alcor6502/SuperCap-UPS-RasPi-Altium/README.md

# Altium Project for RasPi SuperCap UPS & Power Supply

## Follow the project on [Hackaday](https://hackaday.io/project/168748-raspberry-supercapacitor-ups-power-supply)

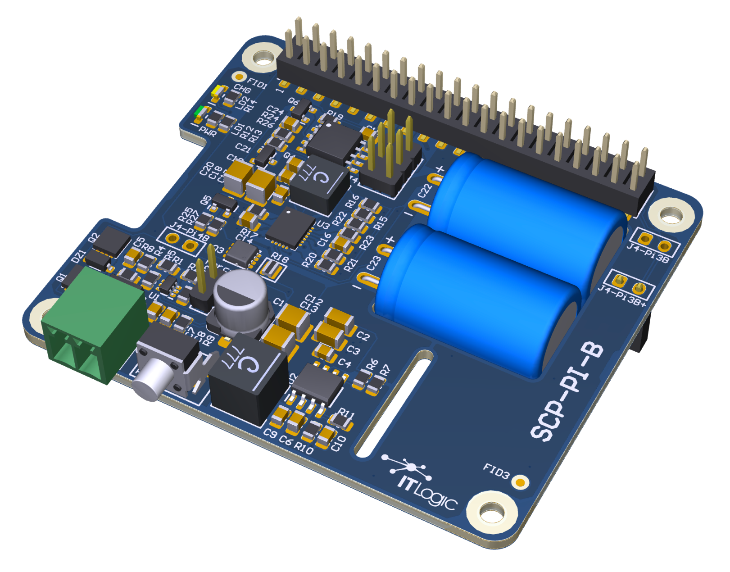
[picture p1: Documentation/Pictures/SCP-PI-B.png]
image info
