alcor6502/SuperCap-UPS-RasPi-Altium/Documentation/Design Rules Check/Design Rules Check.html

Altium

# Design Rule Verification Report

Date: | | 11/17/2019
Time: | | 7:34:54 PM
Elapsed Time: | | 00:00:02
Filename: | | C:\Users\alfredo\AppData\Local\TempReleases\Snapshot\1\SCAP-PI.PcbDoc

Warnings: | | 0
Rule Violations: | | 0

## Summary

Warnings | Count
Total | 0

Rule Violations | Count
Clearance Constraint (Gap=0.2mm) (All),(All) | 0
Clearance Constraint (Gap=0.2mm) (HasFootprint('HLE-120-02-F-DV-BE')),(All) | 0
Short-Circuit Constraint (Allowed=No) (All),(All) | 0
Un-Routed Net Constraint ( (All) ) | 0
Modified Polygon (Allow modified: No), (Allow shelved: No) | 0
Width Constraint (Min=0.2mm) (Max=5mm) (Preferred=0.2mm) (All) | 0
Routing Layers(All) | 0
Routing Via (MinHoleWidth=0.3mm) (MaxHoleWidth=0.6mm) (PreferredHoleWidth=0.3mm) (MinWidth=0.6mm) (MaxWidth=1mm) (PreferedWidth=0.6mm) (All) | 0
Differential Pairs Uncoupled Length using the Gap Constraints (Min=0.2mm) (Max=0.4mm) (Prefered=0.2mm) and Width Constraints (Min=0.3mm) (Max=0.4mm) (Prefered=0.3mm) (All) | 0
SMD To Corner (Distance=0mm) (All) | 0
SMD Entry (Side = Allowed) (Corner = Not Allowed) (Any Angle = Allowed) (Ignore First Corner = Allowed) | 0
Power Plane Connect Rule(Direct Connect )(Expansion=0.5mm) (Conductor Width=0.2mm) (Air Gap=0.2mm) (Entries=4) (All) | 0
Power Plane Connect Rule(Relief Connect )(Expansion=0.3mm) (Conductor Width=0.5mm) (Air Gap=0.2mm) (Entries=4) ((InNet('GND') and IsPad)) | 0
Minimum Annular Ring (Minimum=0.15mm) (All) | 0
Acute Angle Constraint [Tracks Only] (Minimum=0.000) (All) | 0
Hole Size Constraint (Min=0.3mm) (Max=6mm) (All) | 0
Pads and Vias to follow the Drill pairs settings | 0
Hole To Hole Clearance (Gap=0.3mm) (All),(All) | 0
Minimum Solder Mask Sliver (Gap=0.15mm) (All),(All) | 0
Silk To Solder Mask (Clearance=0.1mm) (IsPad),(All) | 0
Silk to Silk (Clearance=0.1mm) (All),(All) | 0
Net Antennae (Tolerance=0mm) (All) | 0
Board Clearance Constraint (Gap=0mm) ((OnLayer('Top Layer') OR OnLayer('Bottom Layer'))) | 0
Component Clearance Constraint ( Horizontal Gap = 0mm, Vertical Gap = 0mm ) (HasFootprint('C-SCCT20B106PRB-ORIZ')),(All) | 0
Component Clearance Constraint ( Horizontal Gap = 0mm, Vertical Gap = 0mm ) (HasFootprint('SSQ-120-03-D-BOTTOM')),(All) | 0
Component Clearance Constraint ( Horizontal Gap = 0mm, Vertical Gap = 0mm ) (Footprint Like('FID-1*')),(All) | 0
Component Clearance Constraint ( Horizontal Gap = 0.2mm, Vertical Gap = 0.2mm ) (All),(All) | 0
Height Constraint (Min=0mm) (Max=50mm) (Prefered=12mm) (All) | 0
Total | 0
