alcor6502/SuperCap-UPS-RasPi-Altium/Documentation/Project Specs/DAC Linerization AVR.xlsx

Ratio Vin/Vout | 3
DAC Resolution | 256
VREF | 2.56
Input Voltage | 3.2
Resistor Divider Voltage | 1.07
Digital Value RAW | 106.67
Correction coefficent | 30
Digital Value COND | 3200
