alcor6502/SuperCap-UPS-RasPi-Altium/Documentation/Project Specs/Parameter Calculator.xlsx

SCAP-PI |  | APP NOTE
RFB1 | 1000 | RFB1 | 1500
RFB2 | 200 | RFB2 | 324
VCHG | 4.80 | VCHG | 4.50
SCAP-PI |  | APP NOTE
RFB1 | 120 | RFB1 | 113
RFB2 | 39 | RFB2 | 38.3
VPF | 4.85 | VPF | 4.70
SCAP-PI |  | APP NOTE
RFB1 | 1050 | RFB1 | 1050
RFB2 | 200 | RFB2 | 200
VSYS | 5.00 | VSYS | 5.00
VSYSGD | 4.62 | VSYSGD | 4.62
LAMP
RFB1 | 100
RFB2 | 9.1
VSYS | 7.15
