alcor6502/SuperCap-UPS-RasPi-Altium/Documentation/Foto/SCP-PI-A-01.jpeg

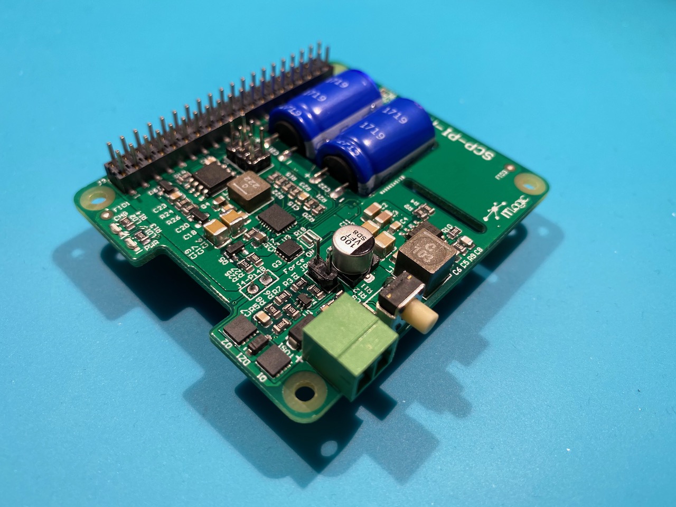
Documentation/Foto/SCP-PI-A-01.jpeg
