alcor6502/SuperCap-UPS-RasPi-Altium/Documentation/Foto/SCP-PI-A-05.jpeg

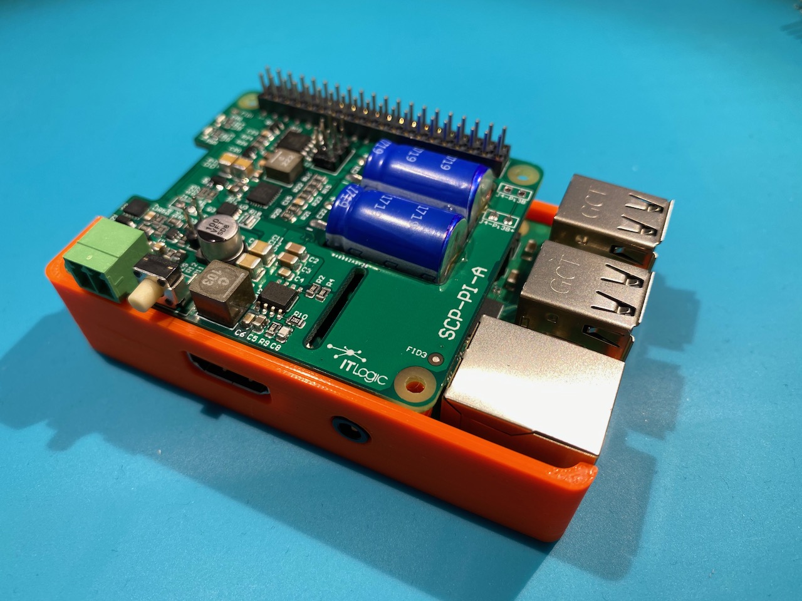
Documentation/Foto/SCP-PI-A-05.jpeg
