alcor6502/SuperCap-UPS-RasPi-Altium/Documentation/Hackday Article/ATTiny25.jpg

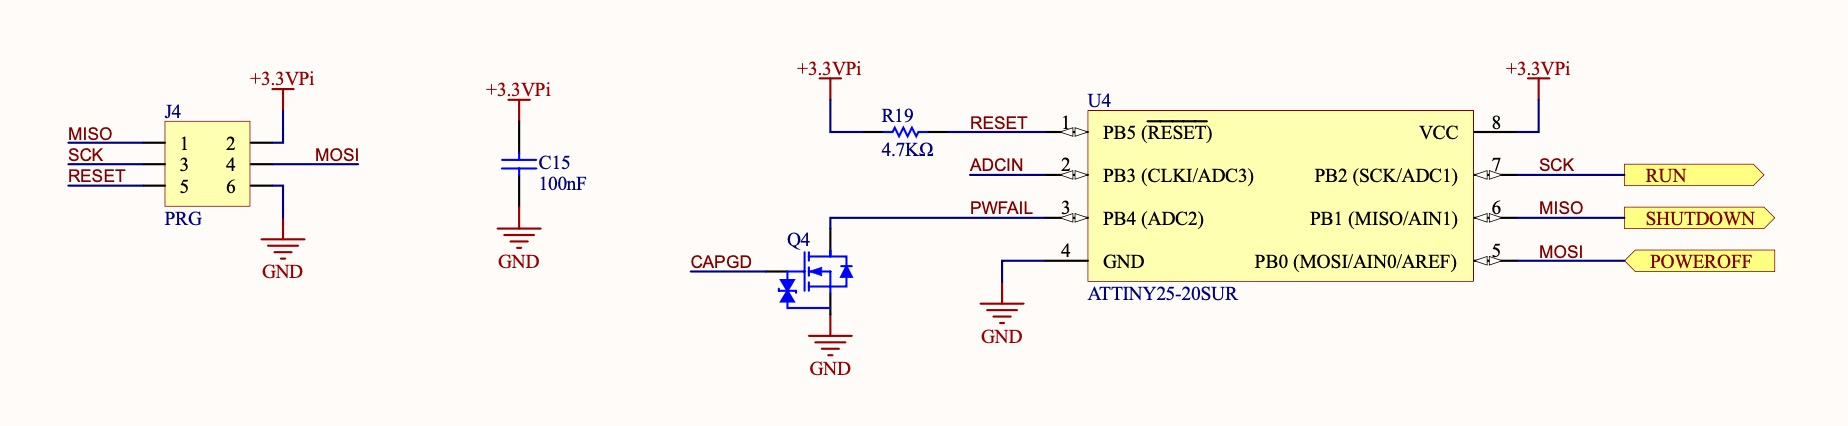
Documentation/Hackday Article/ATTiny25.jpg
