alcor6502/SuperCap-UPS-RasPi-Altium/Documentation/Hackday Article/Lab-Bench.jpeg

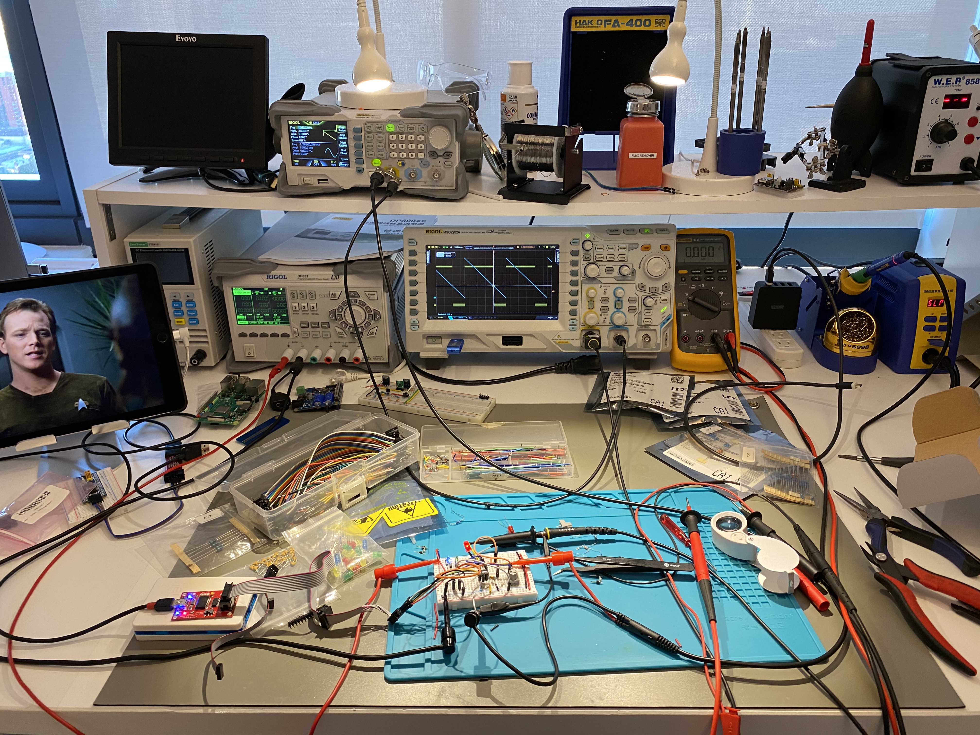
Documentation/Hackday Article/Lab-Bench.jpeg
