alcor6502/SuperCap-UPS-RasPi-Altium/Documentation/Hackday Article/MAX16054-Solution.jpg

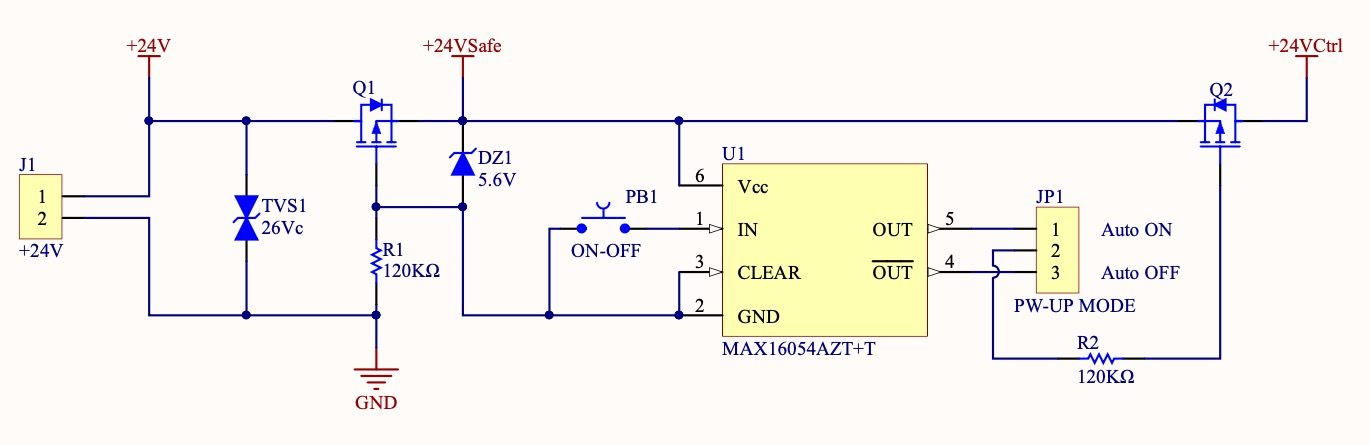
Documentation/Hackday Article/MAX16054-Solution.jpg
