alcor6502/SuperCap-UPS-RasPi-Altium/Documentation/Hackday Article/Original-Circuit.jpg

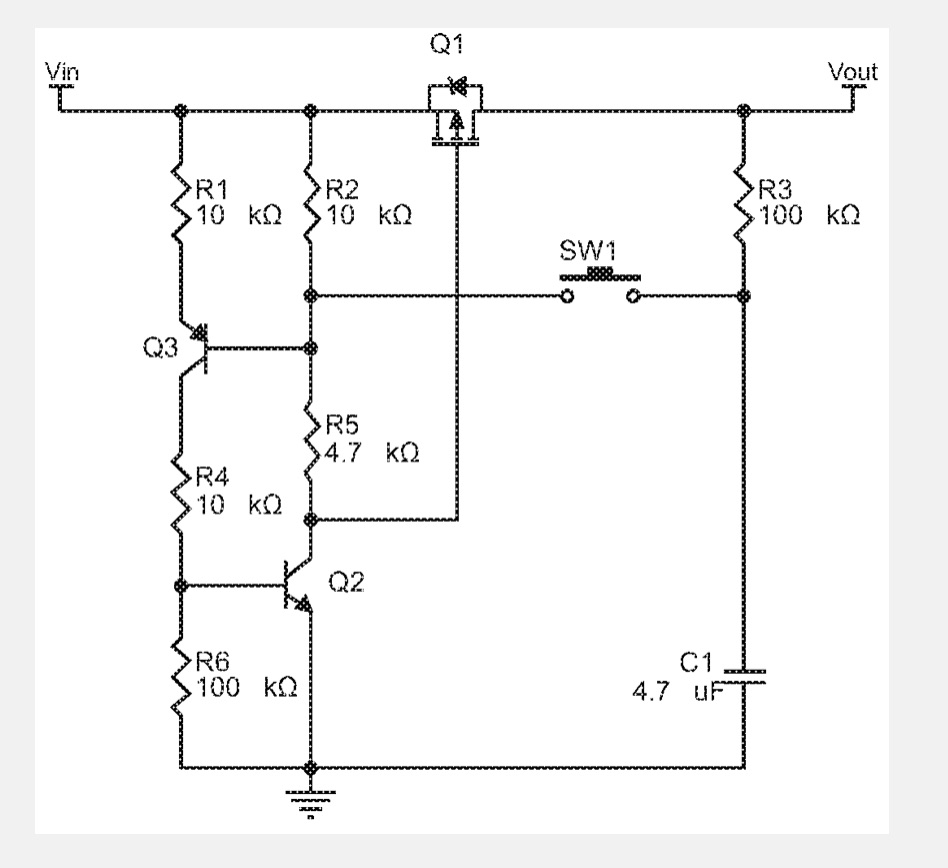
Documentation/Hackday Article/Original-Circuit.jpg
