alcor6502/SuperCap-UPS-RasPi-Altium/Documentation/Hackday Article/Power-Supply.jpg

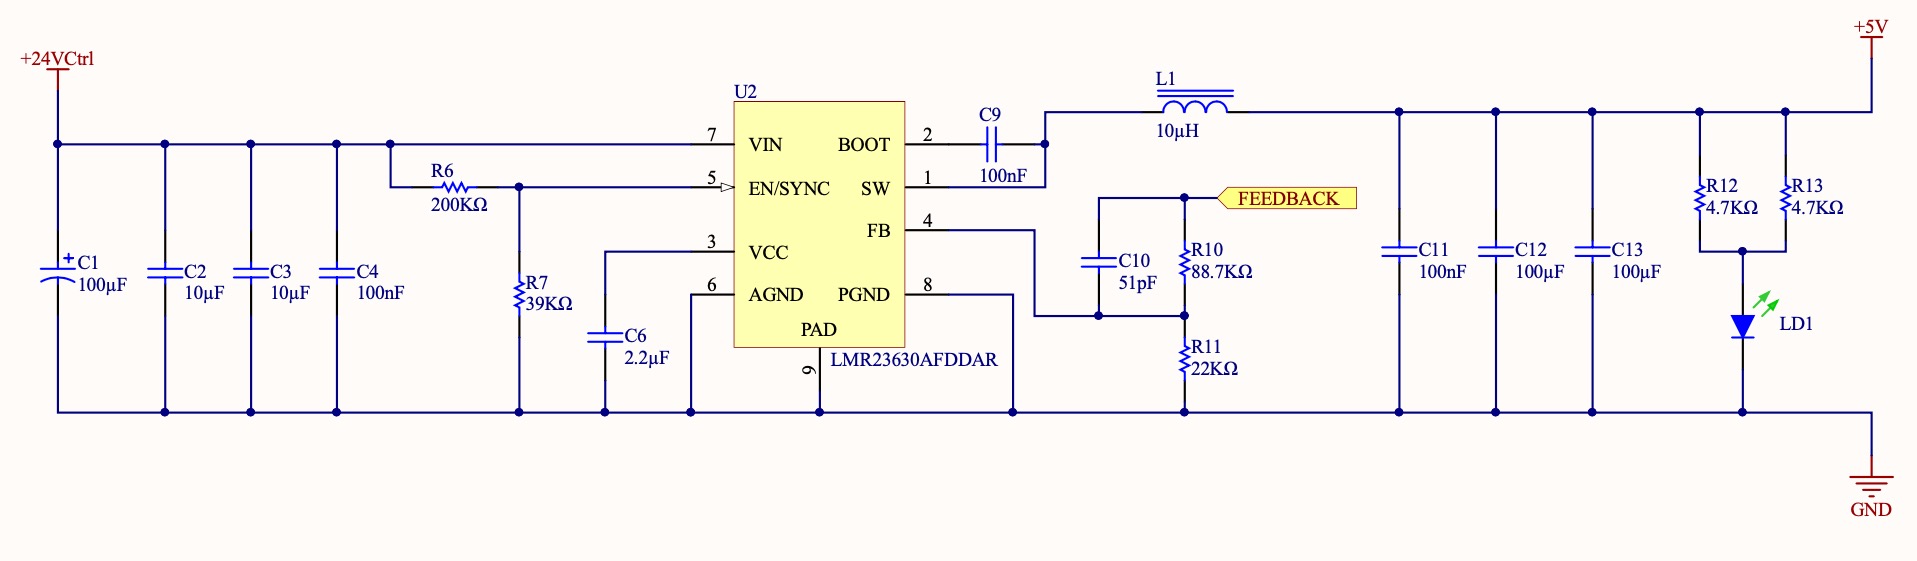
Documentation/Hackday Article/Power-Supply.jpg
