alcor6502/SuperCap-UPS-RasPi-Altium/Documentation/Hackday Article/Soft-Latching-Power-Switch-Circuit.jpg

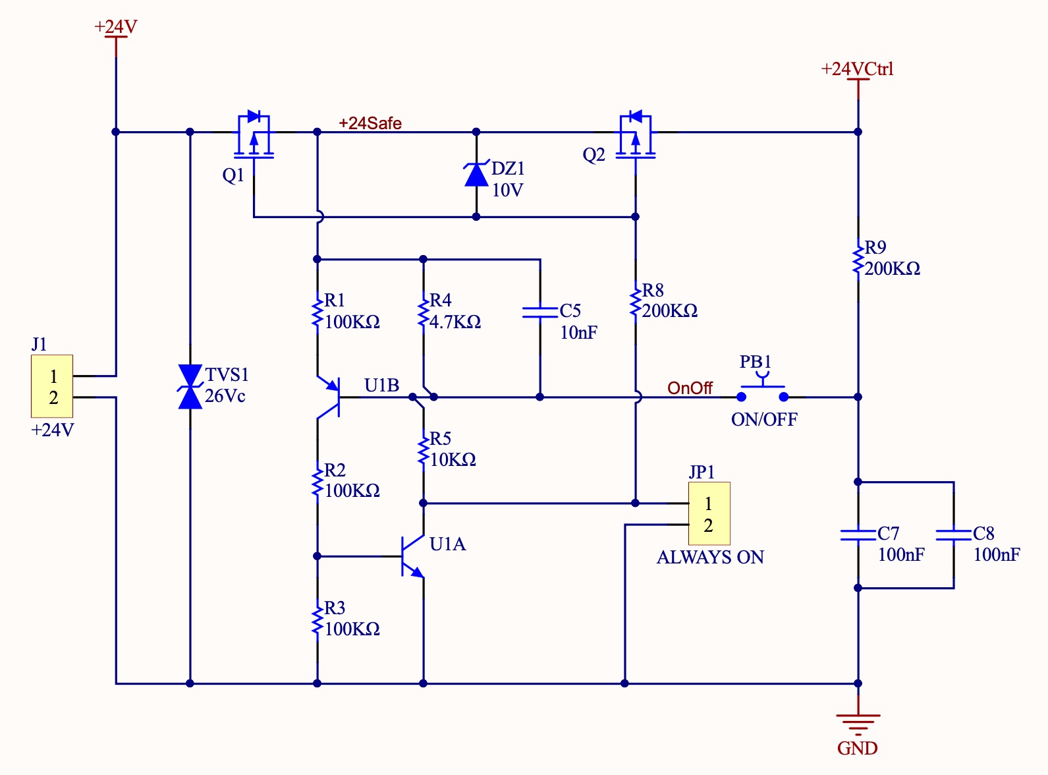
Documentation/Hackday Article/Soft-Latching-Power-Switch-Circuit.jpg
