alcor6502/SuperCap-UPS-RasPi-Altium/Documentation/Hackday Article/SuperCap-UPS.jpg

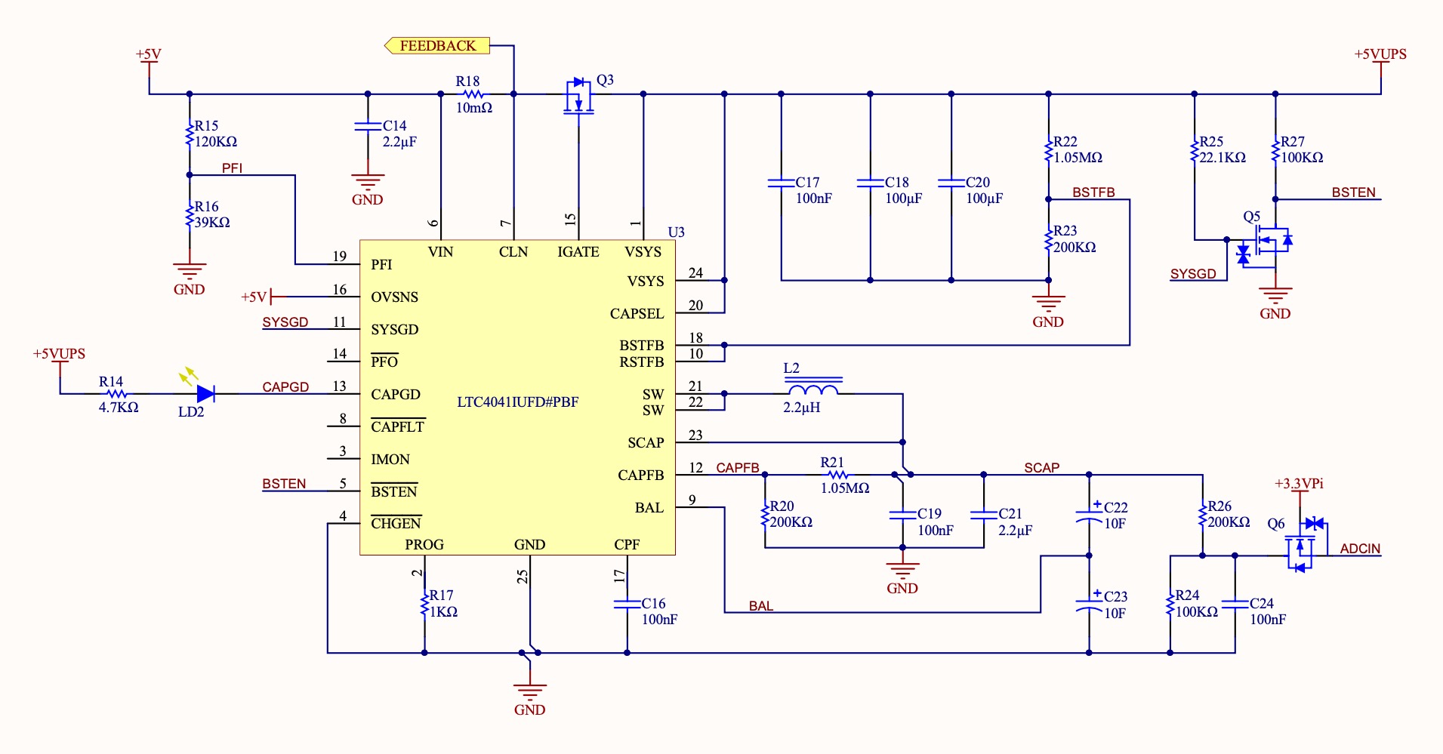
Documentation/Hackday Article/SuperCap-UPS.jpg
