alcor6502/SuperCap-UPS-RasPi-Altium/Documentation/Screen Captures/Power Off with BSTEN Signal - Pulse Load 2A - 20ms Off - 5ms On.png

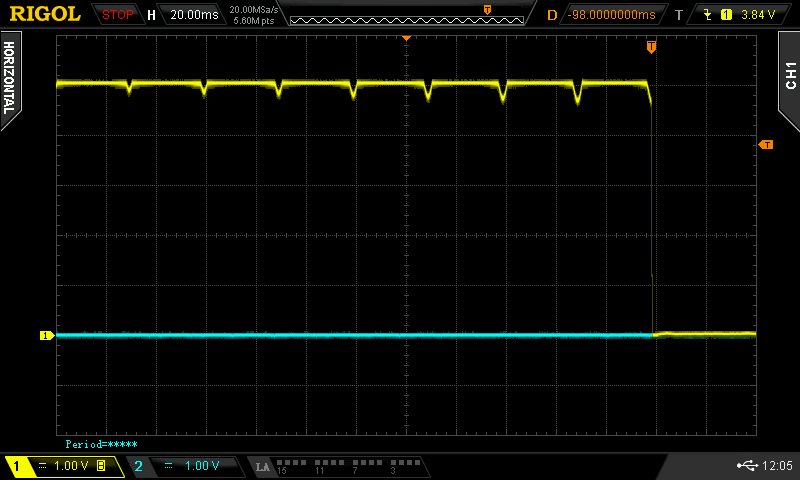
Documentation/Screen Captures/Power Off with BSTEN Signal - Pulse Load 2A - 20ms Off - 5ms On.png
