alcor6502/SuperCap-UPS-RasPi-Altium/Documentation/Screen Captures/Power Off with BSTEN Signal.png

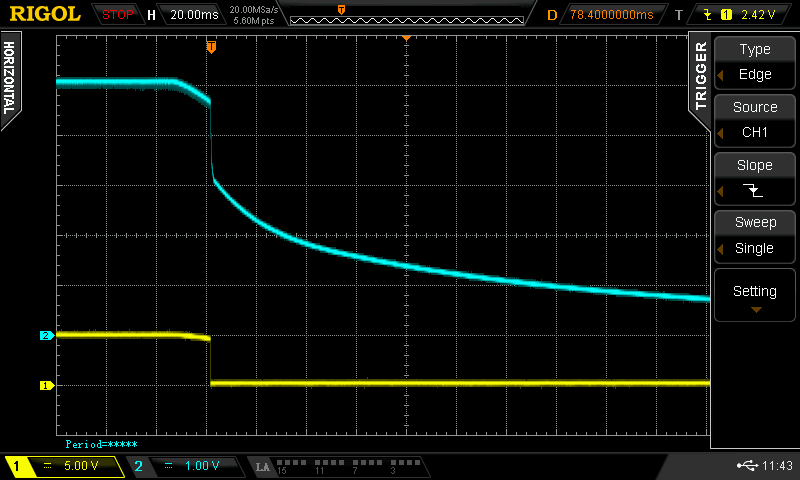
Documentation/Screen Captures/Power Off with BSTEN Signal.png
