alcor6502/SuperCap-UPS-RasPi-Altium/Documentation/Screen Captures/Power Off without BSTEN Signal - Magnified.png

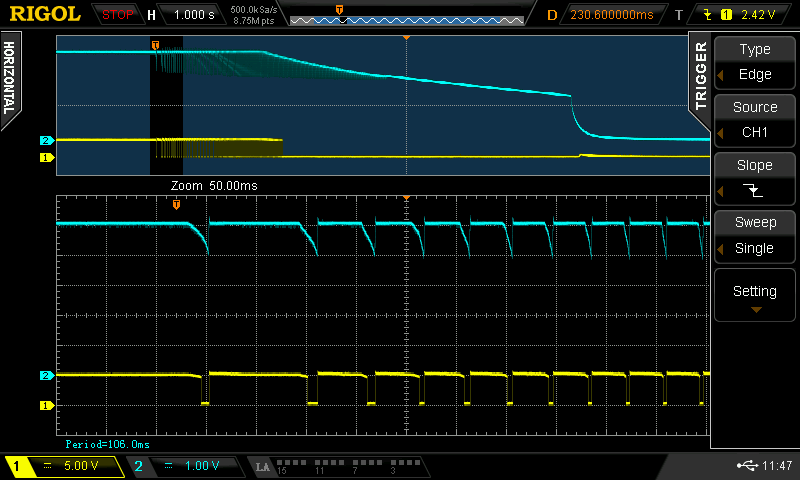
Documentation/Screen Captures/Power Off without BSTEN Signal - Magnified.png
