alcor6502/SuperCap-UPS-RasPi-Altium/Documentation/Screen Captures/Power Off without BSTEN Signal.png

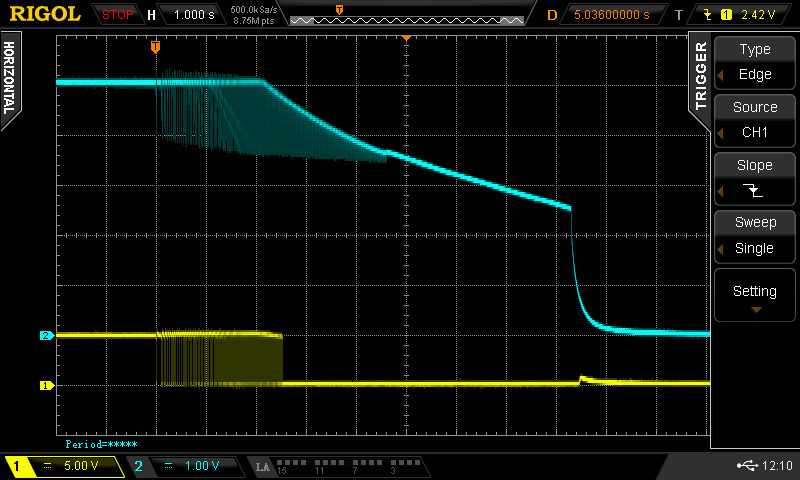
Documentation/Screen Captures/Power Off without BSTEN Signal.png
