alcor6502/SuperCap-UPS-RasPi-Altium/Documentation/Screen Captures/Ripple Boost 0.5A - Polling Shunt and Boost.png

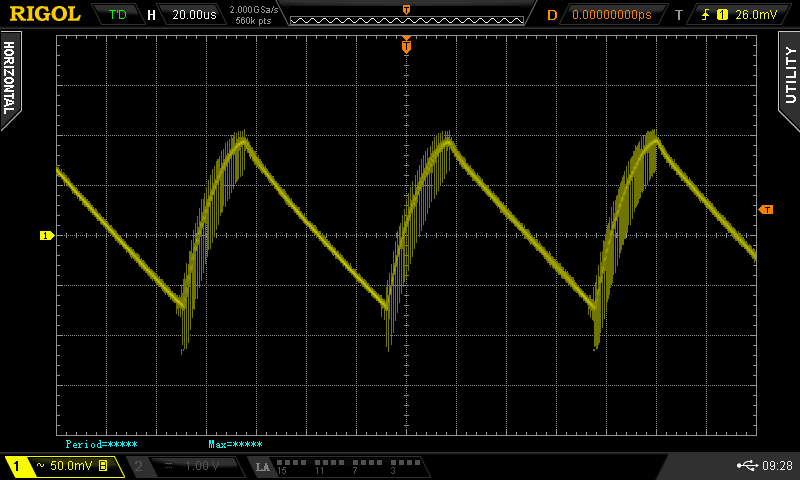
Documentation/Screen Captures/Ripple Boost 0.5A - Polling Shunt and Boost.png
