alcor6502/SuperCap-UPS-RasPi-Altium/Documentation/Screen Captures/Ripple Boost 1A.png

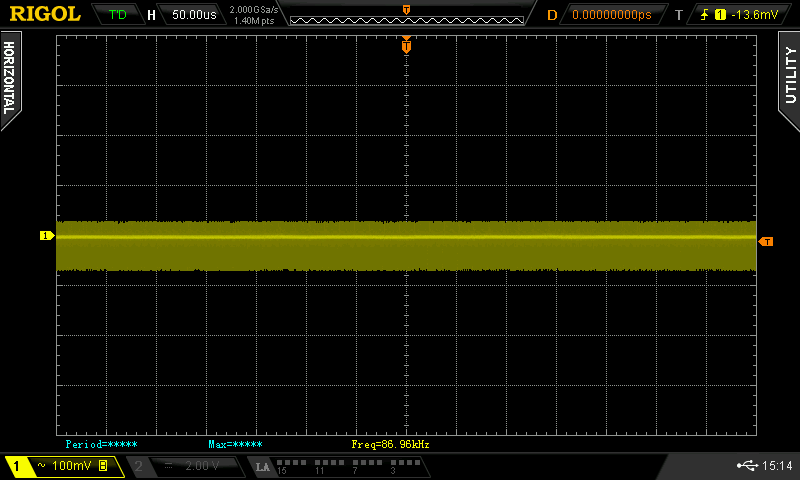
Documentation/Screen Captures/Ripple Boost 1A.png
