alcor6502/SuperCap-UPS-RasPi-Altium/Documentation/Screen Captures/Ripple Boost Transient 2A - 0.1A.png

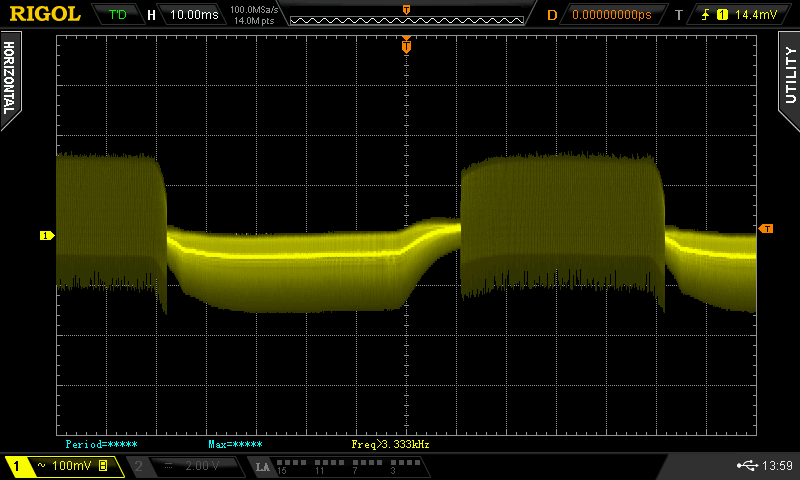
Documentation/Screen Captures/Ripple Boost Transient 2A - 0.1A.png
