alcor6502/SuperCap-UPS-RasPi-Altium/Documentation/Screen Captures/Ripple Buck 1A.png

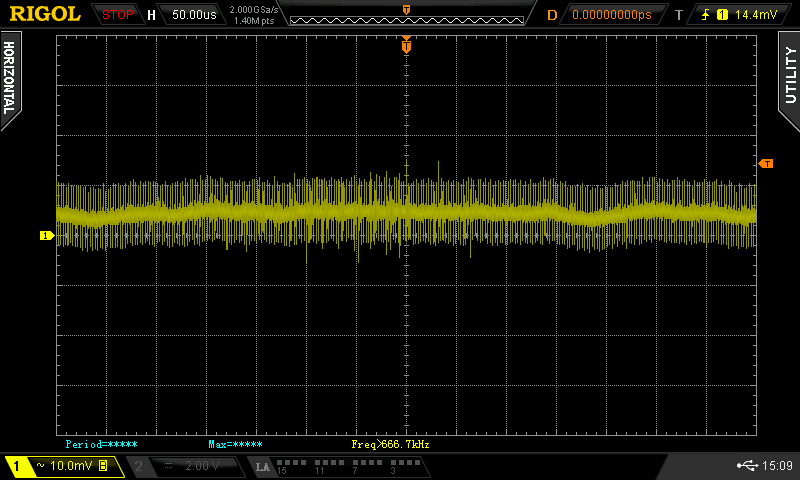
Documentation/Screen Captures/Ripple Buck 1A.png
