alcor6502/SuperCap-UPS-RasPi-Altium/Documentation/Screen Captures/Ripple Buck 2A.png

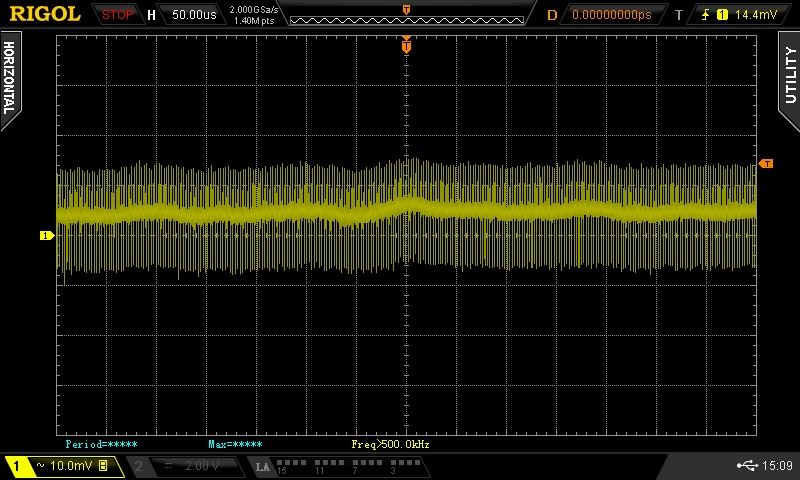
Documentation/Screen Captures/Ripple Buck 2A.png
