alcor6502/SuperCap-UPS-RasPi-Altium/Documentation/Screen Captures/Ripple Buck transient  2A - 0.1A.png

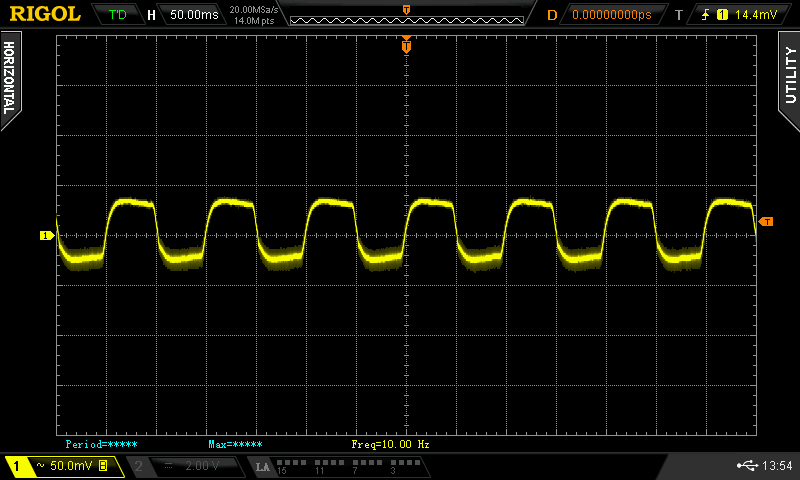
Documentation/Screen Captures/Ripple Buck transient 2A - 0.1A.png
