alcor6502/SuperCap-UPS-RasPi-Altium/Documentation/Screen Captures/Ripple Super Cap Chgarger.png

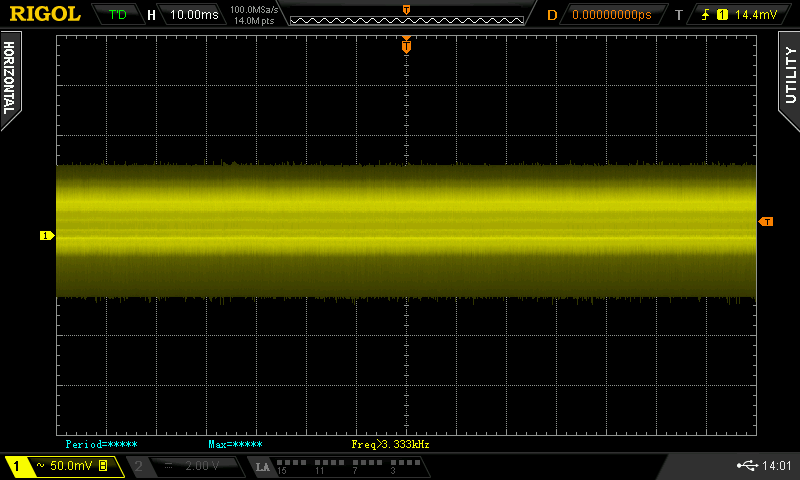
Documentation/Screen Captures/Ripple Super Cap Chgarger.png
