alcor6502/SuperCap-UPS-RasPi-Altium/Documentation/Thermal Scans/Base Line.jpeg

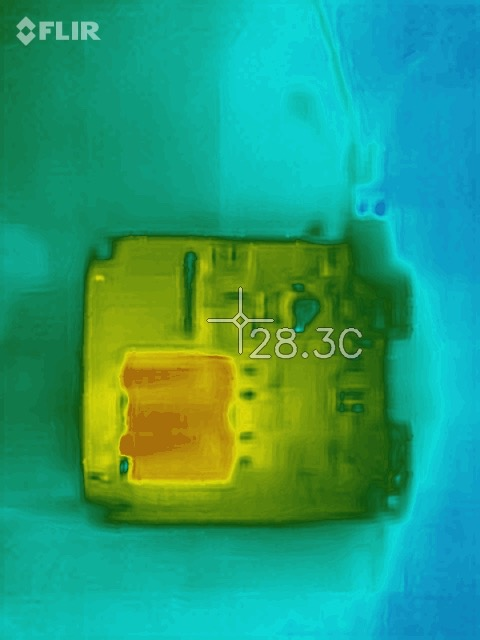
Documentation/Thermal Scans/Base Line.jpeg
