alcor6502/SuperCap-UPS-RasPi-Altium/Documentation/Thermal Scans/Boost Converter 1.5A Load.jpeg

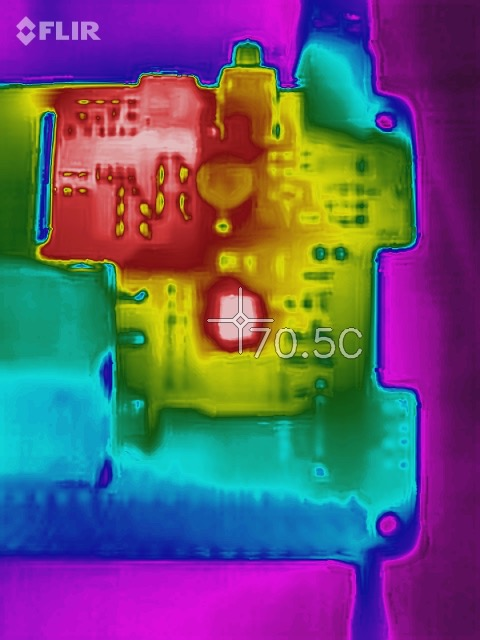
Documentation/Thermal Scans/Boost Converter 1.5A Load.jpeg
