alcor6502/SuperCap-UPS-RasPi-Altium/Documentation/Thermal Scans/Buck Converter 1.5A Load.jpeg

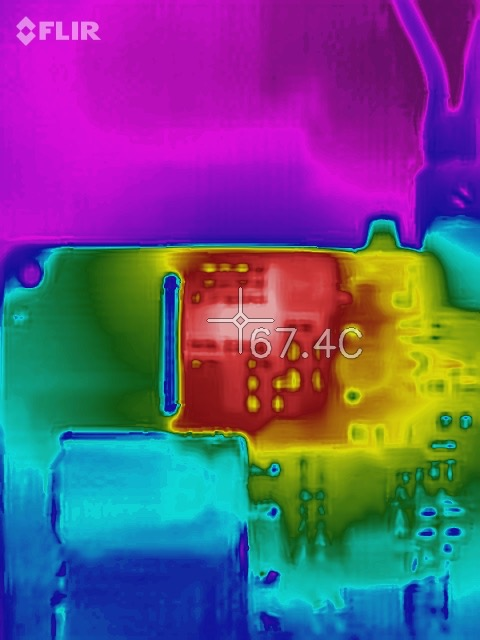
Documentation/Thermal Scans/Buck Converter 1.5A Load.jpeg
