alcor6502/SuperCap-UPS-RasPi-Altium/Documentation/Thermal Scans/Buck Converter 2.5A Load.jpeg

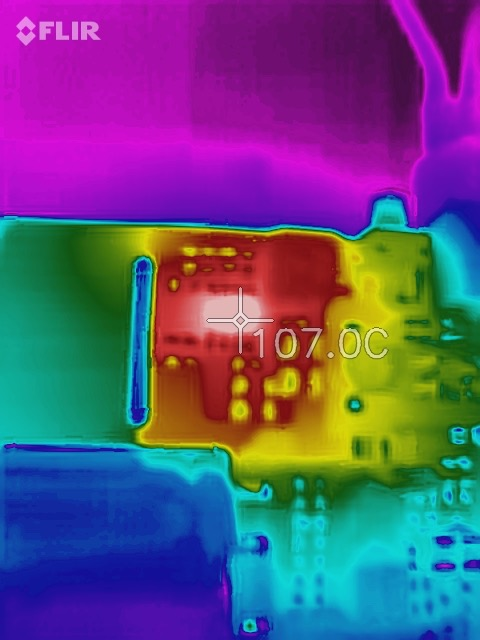
Documentation/Thermal Scans/Buck Converter 2.5A Load.jpeg
