alcor6502/SuperCap-UPS-RasPi-Altium/Documentation/Thermal Scans/Buck Converter No Load.jpeg

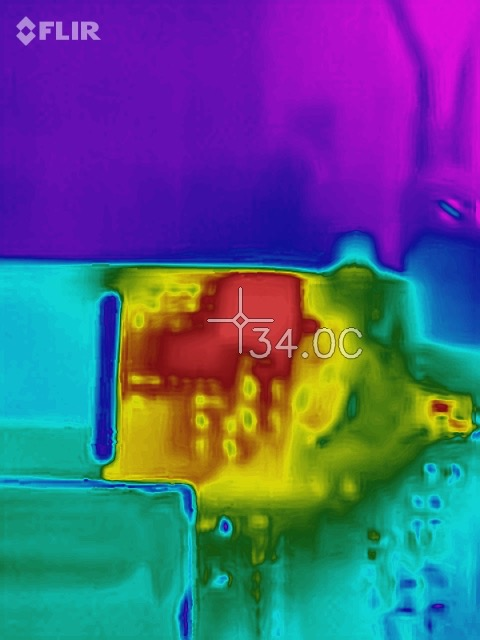
Documentation/Thermal Scans/Buck Converter No Load.jpeg
