alcor6502/SuperCap-UPS-RasPi-Altium/Documentation/Bill of Materials/BOM Basic.xls

Line # | Designator | Manufacturer 1 | Manufacturer Part Number 1 | Quantity | Supplier 1 | Supplier Part Number 1 | Description
1 | C1 | Panasonic | EEEFT1V101AP | 1 | Mouser | 667-EEE-FT1V101AP | Cap Electrolytic Alu 100uF 300V 20% (5.8 X 6.1mm) SMD 600mA 2000h 105C
2 | C2, C3 | Murata | GRT31CR61H106ME01L | 2 | Mouser | 81-GRT31CR61H106ME1L | Cap 1206 Case Ceramic 10uF 50V X5S 20%
3 | C4, C7, C8, C9, C11, C15, C16, C17, C19, C24 | KEMET | C0805C104K5RACTU | 10 | Mouser | 80-C0805C104K5R | Cap 0805 Case Ceramic 100nF 50V X7R
4 | C5 | KEMET | C0805C103K5RACTU | 1 | Mouser | 80-C0805C103K5R | Cap 0805 Case Ceramic 10nF 50V X7R
5 | C6, C14, C21 | KEMET | C0805C225K4RACTU | 3 | Mouser | 80-C0805C225K4R | Cap 0805 Case Ceramic 2.2uF 16V X7R 10%
6 | C10 | KEMET | C0805C510K5GACTU | 1 | Mouser | 80-C0805C510K5G | Cap 0805 Case Ceramic 51pF 50V C0G 10%
7 | C12, C13, C18, C20 | Murata | GRM32ER61A107ME20L | 4 | Mouser | 81-GRM32ER61A107ME0L | Cap 1210 Case Ceramic 100uF 10V X5S 20%
8 | C22, C23 | Kyocera AVX | SCCT20E106SRB | 2 | Mouser | 581-SCCT20E106SRB | Cap Super 10F 3.0V (20 X 12.5mm) ESR 50mOhm
9 | DZ1 | Vishay | BZT52C10-E3-08 | 1 | Mouser | 78-BZT52C10-E3-08 | Diode Zener Single 10V 5% 400mW SOD-123
10 | EXT1 | Samtec | SSQ-120-03-T-D | 1 | Mouser | 200-SSQ12003TD | Conn Post Socket Header Vert - 2 Row - 20 Pos - 10 mm Lenght - Tin
12 | J1 | Wurth Electronics | 691322110002 | 1 | Mouser | 710-691322110002 | Conn Term Block Header 2 Pos 3.5 mm
13 | J2 | Samtec | HLE-120-02-F-DV-BE | 1 | Mouser | 200-HLE12002FDVBE | Conn Socket Header Vert - 2 Row - 20 Pos - SMD
14 | J3 | Samtec | SSQ-102-01-T-S | 1 | Mouser | 200-SSQ10201TS | Conn Post Socket Header Vert - 1 Row - 2 Pos - 3 mm Lenght - Tin
15 | J4 | TE Connectivity | 5-146256-3 | 1 | Mouser | 571-5-146256-3 | Breakaway Header Vert - 2 Row - 3 Pos - 6 mm Lenght - Gold
16 | JP1 | Molex | 22-28-4023 | 1 | Mouser | 538-22-28-4023 | Breakaway Header Vert - 1 Row - 2 Pos - 6 mm Lenght - Gold
17 | L1 | Coilcraft | XAL6060-103MEB | 1 | Mouser | 994-XAL6060-103MEB | Inductor Power XAL60 Series, 10uH, 7.6A, Shielded, 27 mOhm, SMD
18 | L2 | Coilcraft | XAL5030-222MEB | 1 | Mouser | 994-XAL5030-222MEB | Inductor Power SRP6540 Series, 2.2uH, 9.7A, Shielded, 0.0132 ohm, SMD
19 | LD1 | Vishay Lite-On | LTST-S220KGKT | 1 | Mouser | 859-LTST-S220KGKT | LED 0805 Side Green 569nm 2-Pin
20 | LD2 | Vishay Lite-On | LTST-S220KSKT | 1 | Mouser | 859-LTST-S220KSKT | LED 0805 Side Yellow 588nm 2-Pin
21 | LNK1 | TE Connectivity | 2-881545-2 | 1 | Mouser | 571-28815452 | Jumper Red, 2 Pos, 2.54 pitch
22 | PB1 | TE Connectivity | 1-1825027-4 | 1 | Mouser | 506-1-1825027-4 | Tactile Switch, Round Stem, Color ivory, Lenght 3.55mm, Right Angle, Through Hole.
23 | PL1 | Wurth Electronics | 691361100002 | 1 | Mouser | 710-691361100002 | Conn Term Block Plug Vert 2 Pos 3.5 mm
24 | Q1, Q2 | Diodes | DMP6023LFG-7 | 2 | Mouser | 621-DMP6023LFG-7 | Mosfet P 60V Vds 20V Vgs 25mOhm PowerDI3333-8
25 | Q3 | Vishay | SISA88DN-T1-GE3 | 1 | Mouser | 78-SISA88DN-T1-GE3 | Mosfet 30V Vds 20V Vgs 5.4mOhm PowerPAK 1212-8
26 | Q4, Q5, Q6 | Diodes | BSS138K-13 | 3 | Mouser | 621-BSS138K-13 | Mosfet N 50V Vds 20V Vgs ESD 1.4R SOT-23
27 | R1, R2, R3, R24, R27 | Yageo | RC0805FR-07100KL | 5 | Mouser | 603-RC0805FR-07100KL | Resistor 0805 Case 100KR 1% 1/8W
28 | R4, R12, R13, R14, R19 | Yageo | RC0805FR-074K7L | 5 | Mouser | 603-RC0805FR-074K7L | Resistor 0805 Case 4.7KR 1% 1/8W
29 | R5 | Yageo | RC0805FR-0710KL | 1 | Mouser | 603-RC0805FR-0710KL | Resistor 0805 Case 10KR 1% 1/8W
30 | R6, R8, R9, R20, R23, R26 | Yageo | RC0805FR-07200KL | 6 | Mouser | 603-RC0805FR-07200KL | Resistor 0805 Case 200KR 1% 1/8W
31 | R7, R16 | Yageo | RC0805FR-0739KL | 2 | Mouser | 603-RC0805FR-0739KL | Resistor 0805 Case 39KR 1% 1/8W
32 | R10 | Yageo | RC0805FR-0788K7L | 1 | Mouser | 603-RC0805FR-0788K7L | Resistor 0805 Case 88.7KR 1% 1/8W
33 | R11 | Yageo | RC0805FR-0722KL | 1 | Mouser | 603-RC0805FR-0722KL | Resistor 0805 Case 22KR 1% 1/8W
34 | R15 | Yageo | RC0805FR-07120KL | 1 | Mouser | 603-RC0805FR-07120KL | Resistor 0805 Case 120KR 1% 1/8W
35 | R17 | Yageo | RC0805FR-071KL | 1 | Mouser | 603-RC0805FR-071KL | Resistor 0805 Case 1KR 1% 1/8W
36 | R18 | Susumu | KRL2012E-M-R010-F-T5 | 1 | Mouser | 754-KRL2012EMR010FT5 | Resistor 0508 Case 10mR 1% 1/2W Current Sense
37 | R21, R22 | Yageo | RC0805FR-071M05L | 2 | Mouser | 603-RC0805FR-071M05L | Resistor 0805 Case 1.05MR 1% 1/8W
38 | R25 | Yageo | RC0805FR-0722K1L | 1 | Mouser | 603-RC0805FR-0722K1L | Resistor 0805 Case 22.1KR 1% 1/8W
39 | TVS1 | Littelfuse | SMAJ26CA | 1 | Mouser | 576-SMAJ26CA | TVS Diode Bidirectional 26Vs, 42.1Vc, 9.5 Amp, SMA
40 | U1 | ON Semiconductor | MBT3946DW1T1G | 1 | Mouser | 863-MBT3946DW1T1G | Transistor Complementary Dual 40V 200mA SOT−363
41 | U2 | Texas Instruments | LMR23630AFDDAR | 1 | Mouser | 595-LMR23630AFDDAR | Conv DC-DC Sync Step-Down 36V 3A 9-Pin(8+Pab) HSOIC-8
42 | U3 | Analog Devices | LTC4041IUFD#PBF | 1 | Mouser | 584-4041IUFDPB | Power Management 2.5A Supercapacitor Backup Buck Converter and Charger
43 | U4 | Microchip | ATTINY25-20SUR | 1 | Mouser | 556-ATTINY25-20SUR | AVR MCU8-bit ATTiny - 2kB Flash 0.128kB EEPROM 6 I/O Pins - SOIC-8-W
