alcor6502/SuperCap-UPS-RasPi-Altium/Documentation/Bill of Materials/BOM Complete.xlsx

Board: SCP-PI-B |  |  |  |  |  |  |  | SCP-PI-B | IT Logic 5753 Highway 85 N Crestview, FL 32536 Tel: +1 (866) 526-0058 Email: pcb-design@itlogic.solutions
Project: SuperCap UPS Rasp Pi |  |  |  |  |  |  |  | SuperCap UPS Rasp Pi
Revision: B |  |  |  |  |  |  |  | B
Variant: None |  |  |  |  |  |  |  | None
Date: Nov-17-2019 |  |  |  |  |  |  |  | 11/17/2019
Line # | Designator | Manufacturer 1 | Manufacturer Part Number 1 | Description | Case | Mount | Quantity | Supplier 1 | Supplier Part Number 1 | Supplier Order Qty 1 | Supplier Stock 1 | Supplier Unit Price 1 | Supplier Subtotal 1
1 | C1 | Panasonic | EEEFT1V101AP | Cap Electrolytic Alu 100uF 300V 20% (5.8 X 6.1mm) SMD 600mA 2000h 105C | D8 | Surface Mount | 1 | Mouser | 667-EEE-FT1V101AP | 100 | 51113 | 0.20 | 20.30
2 | C2, C3 | Murata | GRT31CR61H106ME01L | Cap 1206 Case Ceramic 10uF 50V X5S 20% | 1206 | Surface Mount | 2 | Mouser | 81-GRT31CR61H106ME1L | 200 | 944234 | 0.22 | 43.80
3 | C4, C7, C8, C9, C11, C15, C16, C17, C19, C24 | KEMET | C0805C104K5RACTU | Cap 0805 Case Ceramic 100nF 50V X7R | 0805 | Surface Mount | 10 | Mouser | 80-C0805C104K5R | 1000 | 3219833 | 0.04 | 37.00
4 | C5 | KEMET | C0805C103K5RACTU | Cap 0805 Case Ceramic 10nF 50V X7R | 0805 | Surface Mount | 1 | Mouser | 80-C0805C103K5R | 100 | 1165207 | 0.04 | 4.40
5 | C6, C14, C21 | KEMET | C0805C225K4RACTU | Cap 0805 Case Ceramic 2.2uF 16V X7R 10% | 0805 | Surface Mount | 3 | Mouser | 80-C0805C225K4R | 300 | 298211 | 0.09 | 27.90
6 | C10 | KEMET | C0805C510K5GACTU | Cap 0805 Case Ceramic 51pF 50V C0G 10% | 0805 | Surface Mount | 1 | Mouser | 80-C0805C510K5G | 100 | 2407 | 0.09 | 8.60
7 | C12, C13, C18, C20 | Murata | GRM32ER61A107ME20L | Cap 1210 Case Ceramic 100uF 10V X5S 20% | 1210 | Surface Mount | 4 | Mouser | 81-GRM32ER61A107ME0L | 400 | 152911 | 0.65 | 261.20
8 | C22, C23 | Kyocera AVX | SCCT20E106SRB | Cap Super 10F 3.0V (20 X 12.5mm) ESR 50mOhm |  | Through Hole | 2 | Mouser | 581-SCCT20E106SRB | 200 | 801 | 2.06 | 412.00
9 | DZ1 | Vishay | BZT52C10-E3-08 | Diode Zener Single 10V 5% 400mW SOD-123 | SOD-123 | Surface Mount | 1 | Mouser | 78-BZT52C10-E3-08 | 100 | 10424 | 0.09 | 8.90
10 | EXT1 | Samtec | SSQ-120-03-T-D | Conn Post Socket Header Vert - 2 Row - 20 Pos - 10 mm Lenght - Tin |  | Free Hanging | 1 | Mouser | 200-SSQ12003TD | 100 | 305 | 2.50 | 250.00
12 | J1 | Wurth Electronics | 691322110002 | Conn Term Block Header 2 Pos 3.5 mm |  | Through Hole | 1 | Mouser | 710-691322110002 | 100 | 182 | 0.29 | 28.60
13 | J2 | Samtec | HLE-120-02-F-DV-BE | Conn Socket Header Vert - 2 Row - 20 Pos - SMD |  | Surface Mount | 1 | Mouser | 200-HLE12002FDVBE | 100 | 257 | 3.66 | 366.00
14 | J3 | Samtec | SSQ-102-01-T-S | Conn Post Socket Header Vert - 1 Row - 2 Pos - 3 mm Lenght - Tin |  | Through Hole | 1 | Mouser | 200-SSQ10201TS | 100 | 482 | 0.32 | 31.80
15 | J4 | TE Connectivity | 5-146256-3 | Breakaway Header Vert - 2 Row - 3 Pos - 6 mm Lenght - Gold |  | Through Hole | 1 | Mouser | 571-5-146256-3 | 100 | 352 | 0.57 | 56.70
16 | JP1 | Molex | 22-28-4023 | Breakaway Header Vert - 1 Row - 2 Pos - 6 mm Lenght - Gold |  | Through Hole | 1 | Mouser | 538-22-28-4023 | 100 | 26082 | 0.11 | 10.60
17 | L1 | Coilcraft | XAL6060-103MEB | Inductor Power XAL60 Series, 10uH, 7.6A, Shielded, 27 mOhm, SMD |  | Surface Mount | 1 | Mouser | 994-XAL6060-103MEB | 100 | 1542 | 2.25 | 225.00
18 | L2 | Coilcraft | XAL5030-222MEB | Inductor Power SRP6540 Series, 2.2uH, 9.7A, Shielded, 0.0132 ohm, SMD |  | Surface Mount | 1 | Mouser | 994-XAL5030-222MEB | 100 | 4173 | 1.66 | 166.00
19 | LD1 | Vishay Lite-On | LTST-S220KGKT | LED 0805 Side Green 569nm 2-Pin | 0805 | Surface Mount | 1 | Mouser | 859-LTST-S220KGKT | 100 | 73108 | 0.07 | 6.60
20 | LD2 | Vishay Lite-On | LTST-S220KSKT | LED 0805 Side Yellow 588nm 2-Pin | 0805 | Surface Mount | 1 | Mouser | 859-LTST-S220KSKT | 100 | 5489 | 0.08 | 7.80
21 | LNK1 | TE Connectivity | 2-881545-2 | Jumper Red, 2 Pos, 2.54 pitch |  | Free Hanging | 1 | Mouser | 571-28815452 | 100 | 27995 | 0.11 | 10.60
22 | PB1 | TE Connectivity | 1-1825027-4 | Tactile Switch, Round Stem, Color ivory, Lenght 3.55mm, Right Angle, Through Hole. |  | Through Hole | 1 | Mouser | 506-1-1825027-4 | 100 | 23287 | 0.17 | 16.90
23 | PL1 | Wurth Electronics | 691361100002 | Conn Term Block Plug Vert 2 Pos 3.5 mm |  | Free Hanging | 1 | Mouser | 710-691361100002 | 100 | 799 | 0.95 | 95.20
24 | Q1, Q2 | Diodes | DMP6023LFG-7 | Mosfet P 60V Vds 20V Vgs 25mOhm PowerDI3333-8 | PowerDI3333-8 | Surface Mount | 2 | Mouser | 621-DMP6023LFG-7 | 200 | 19523 | 0.46 | 92.00
25 | Q3 | Vishay | SISA88DN-T1-GE3 | Mosfet 30V Vds 20V Vgs 5.4mOhm PowerPAK 1212-8 | PowerPAK 1212-8 | Surface Mount | 1 | Mouser | 78-SISA88DN-T1-GE3 | 100 | 4648 | 0.32 | 31.80
26 | Q4, Q5, Q6 | Diodes | BSS138K-13 | Mosfet N 50V Vds 20V Vgs ESD 1.4R SOT-23 | SOT-23 | Surface Mount | 3 | Mouser | 621-BSS138K-13 | 300 | 58865 | 0.08 | 25.20
27 | R1, R2, R3, R24, R27 | Yageo | RC0805FR-07100KL | Resistor 0805 Case 100KR 1% 1/8W | 0805 | Surface Mount | 5 | Mouser | 603-RC0805FR-07100KL | 500 | 2713872 | 0.01 | 5.50
28 | R4, R12, R13, R14, R19 | Yageo | RC0805FR-074K7L | Resistor 0805 Case 4.7KR 1% 1/8W | 0805 | Surface Mount | 5 | Mouser | 603-RC0805FR-074K7L | 500 | 812077 | 0.01 | 5.50
29 | R5 | Yageo | RC0805FR-0710KL | Resistor 0805 Case 10KR 1% 1/8W | 0805 | Surface Mount | 1 | Mouser | 603-RC0805FR-0710KL | 100 | 3834594 | 0.01 | 1.10
30 | R6, R8, R9, R20, R23, R26 | Yageo | RC0805FR-07200KL | Resistor 0805 Case 200KR 1% 1/8W | 0805 | Surface Mount | 6 | Mouser | 603-RC0805FR-07200KL | 600 | 12755 | 0.01 | 6.60
31 | R7, R16 | Yageo | RC0805FR-0739KL | Resistor 0805 Case 39KR 1% 1/8W | 0805 | Surface Mount | 2 | Mouser | 603-RC0805FR-0739KL | 200 | 49507 | 0.01 | 2.20
32 | R10 | Yageo | RC0805FR-0788K7L | Resistor 0805 Case 88.7KR 1% 1/8W | 0805 | Surface Mount | 1 | Mouser | 603-RC0805FR-0788K7L | 100 | 21941 | 0.01 | 1.10
33 | R11 | Yageo | RC0805FR-0722KL | Resistor 0805 Case 22KR 1% 1/8W | 0805 | Surface Mount | 1 | Mouser | 603-RC0805FR-0722KL | 100 | 397584 | 0.01 | 1.10
34 | R15 | Yageo | RC0805FR-07120KL | Resistor 0805 Case 120KR 1% 1/8W | 0805 | Surface Mount | 1 | Mouser | 603-RC0805FR-07120KL | 100 | 169757 | 0.01 | 1.10
35 | R17 | Yageo | RC0805FR-071KL | Resistor 0805 Case 1KR 1% 1/8W | 0805 | Surface Mount | 1 | Mouser | 603-RC0805FR-071KL | 100 | 4728166 | 0.01 | 1.10
36 | R18 | Susumu | KRL2012E-M-R010-F-T5 | Resistor 0508 Case 10mR 1% 1/2W Current Sense | 0508 | Surface Mount | 1 | Mouser | 754-KRL2012EMR010FT5 | 100 | 17559 | 0.31 | 31.20
37 | R21, R22 | Yageo | RC0805FR-071M05L | Resistor 0805 Case 1.05MR 1% 1/8W | 0805 | Surface Mount | 2 | Mouser | 603-RC0805FR-071M05L | 200 | 61319 | 0.01 | 2.20
38 | R25 | Yageo | RC0805FR-0722K1L | Resistor 0805 Case 22.1KR 1% 1/8W | 0805 | Surface Mount | 1 | Mouser | 603-RC0805FR-0722K1L | 100 | 110866 | 0.01 | 1.10
39 | TVS1 | Littelfuse | SMAJ26CA | TVS Diode Bidirectional 26Vs, 42.1Vc, 9.5 Amp, SMA | SMA | Surface Mount | 1 | Mouser | 576-SMAJ26CA | 100 | 5312 | 0.13 | 13.30
40 | U1 | ON Semiconductor | MBT3946DW1T1G | Transistor Complementary Dual 40V 200mA SOT−363 | SDIP-6 | Surface Mount | 1 | Mouser | 863-MBT3946DW1T1G | 100 | 44171 | 0.06 | 5.90
41 | U2 | Texas Instruments | LMR23630AFDDAR | Conv DC-DC Sync Step-Down 36V 3A 9-Pin(8+Pab) HSOIC-8 | HSOIC-8 | Surface Mount | 1 | Mouser | 595-LMR23630AFDDAR | 100 | 9696 | 2.40 | 240.00
42 | U3 | Analog Devices | LTC4041IUFD#PBF | Power Management 2.5A Supercapacitor Backup Buck Converter and Charger | QFN-24 | Surface Mount | 1 | Mouser | 584-4041IUFDPB | 100 | 1272 | 4.39 | 439.00
43 | U4 | Microchip | ATTINY25-20SUR | AVR MCU8-bit ATTiny - 2kB Flash 0.128kB EEPROM 6 I/O Pins - SOIC-8-W | SOIC-8-W | Surface Mount | 1 | Mouser | 556-ATTINY25-20SUR | 100 | 2948 | 0.89 | 89.00
 | Total Parts | 42 |  |  |  |  | 100 | pcs: | Total | $3091.90
 | Surface Mount Parts | 33
 | Through Hole Parts | 6 |  |  |  |  |  |  | Price for 1pcs | $30.92
 | Free Hanging Parts | 3
