alcor6502/SuperCap-UPS-RasPi-Altium/Documentation/3D Printing/Super Cap Lead Bender - Top.stl

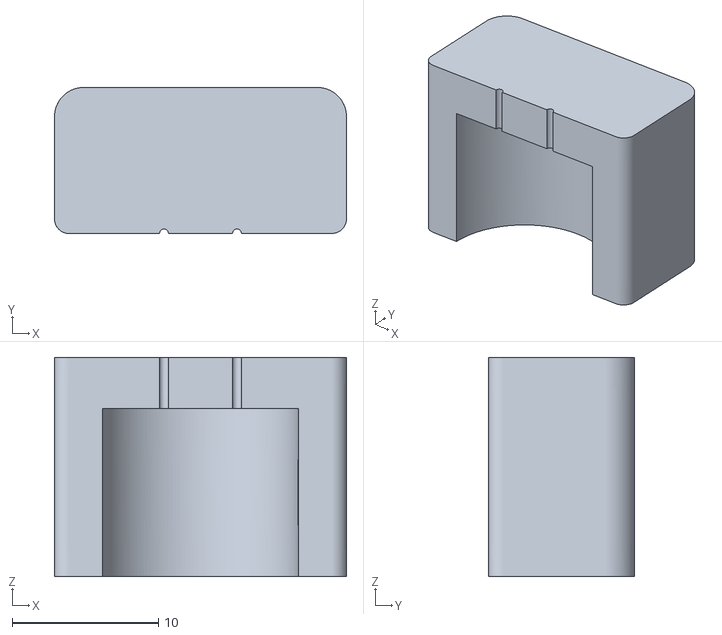
[picture p37: CAD file, 2022-05-01]
Documentation/3D Printing/Super Cap Lead Bender - Top.stl
20.0 x 10.0 x 15.0
