alcor6502/SuperCap-UPS-RasPi-Altium/Documentation/3D Printing/Super Cap Lead Bender - Bottom.stl

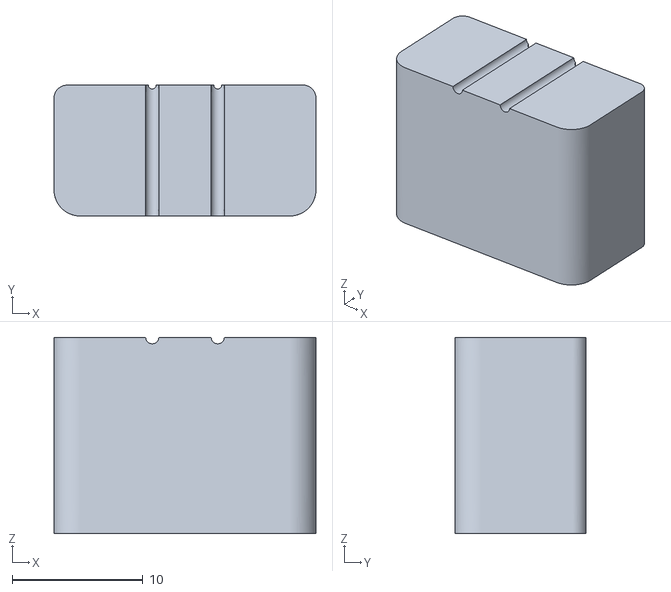
[picture p38: CAD file, 2022-05-01]
Documentation/3D Printing/Super Cap Lead Bender - Bottom.stl
20.0 x 10.0 x 15.0
