alcor6502/SuperCap-UPS-RasPi-Altium/Documentation/Screen Captures/ADC Calibration.png

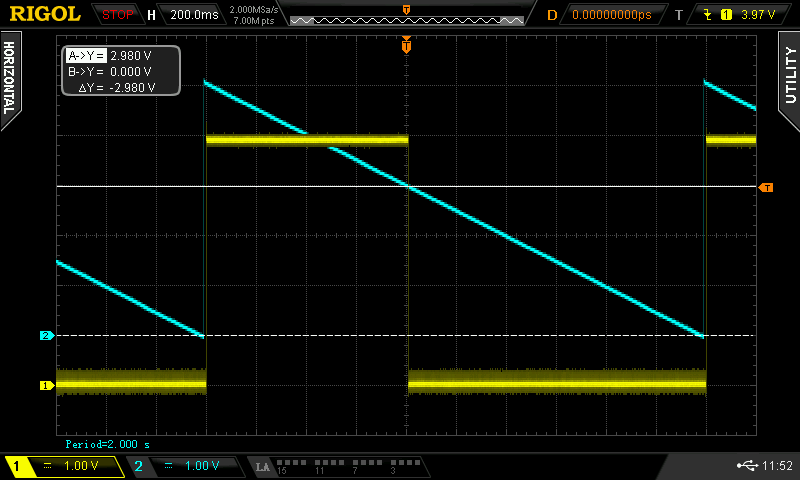
Documentation/Screen Captures/ADC Calibration.png
