alcor6502/SuperCap-UPS-RasPi-Altium/Documentation/Drawings/Board Assembly.PDF

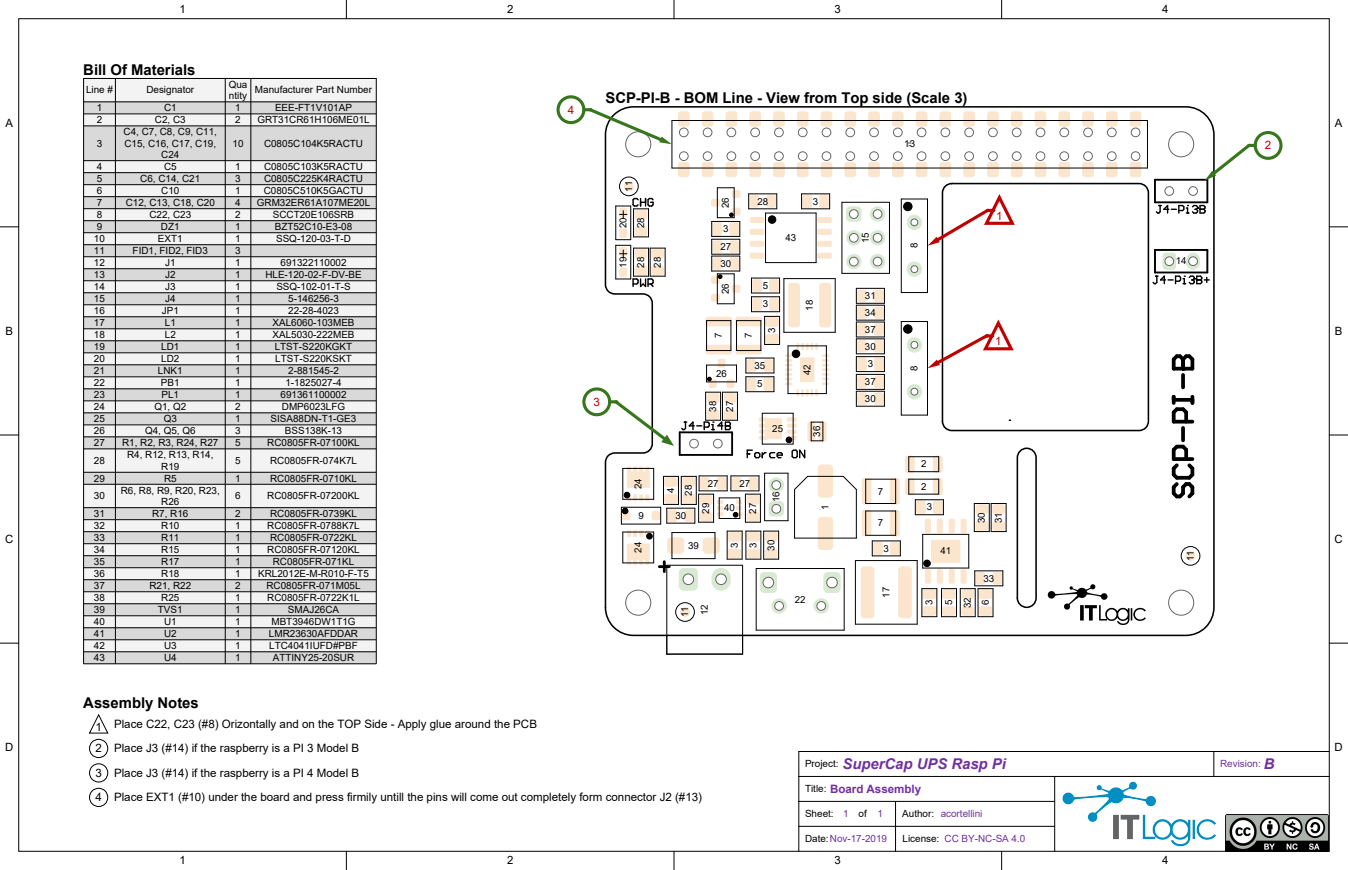
[picture p40: page 1]

Line # | Designator | Qua ntity | Manufacturer Part Number

SCP-PI-B - BOM Line - View from Top side (Scale 3)

1 | C1 | 1 | EEE-FT1V101AP
2 | C2, C3 | 2 | GRT31CR61H106ME01L
3 | C4, C7, C8, C9, C11, C15, C16, C17, C19, C24 | 10 | C0805C104K5RACTU

4 | C5 | 1 | C0805C103K5RACTU
5 | C6, C14, C21 | 3 | C0805C225K4RACTU
6 | C10 | 1 | C0805C510K5GACTU

17 | L1 | 1 | XAL6060-103MEB
18 | L2 | 1 | XAL5030-222MEB

23 | PL1 | 1 | 691361100002
24 | Q1, Q2 | 2 | DMP6023LFG
25 | Q3 | 1 | SISA88DN-T1-GE3

27 | R1, R2, R3, R24, R27 | 5 | RC0805FR-07100KL
28 | R4, R12, R13, R14, R19 | 5 | RC0805FR-074K7L

35 | R17 | 1 | RC0805FR-071KL
36 | R18 | 1 | KRL2012E-M-R010-F-T5
37 | R21, R22 | 2 | RC0805FR-071M05L

39 | TVS1 | 1 | SMAJ26CA
40 | U1 | 1 | MBT3946DW1T1G
41 | U2 | 1 | LMR23630AFDDAR
42 | U3 | 1 | LTC4041IUFD#PBF
43 | U4 | 1 | ATTINY25-20SUR

Assembly Notes
1 Place C22, C23 (#8) Orizontally and on the TOP Side - Apply glue around the PCB

2 Place J3 (#14) if the raspberry is a PI 3 Model B

3 Place J3 (#14) if the raspberry is a PI 4 Model B

4 Place EXT1 (#10) under the board and press firmily untill the pins will come out completely form connector J2 (#13)

License: CC BY-NC-SA 4.0
