alcor6502/SuperCap-UPS-RasPi-Altium/Documentation/Drawings/Board Specifications.PDF

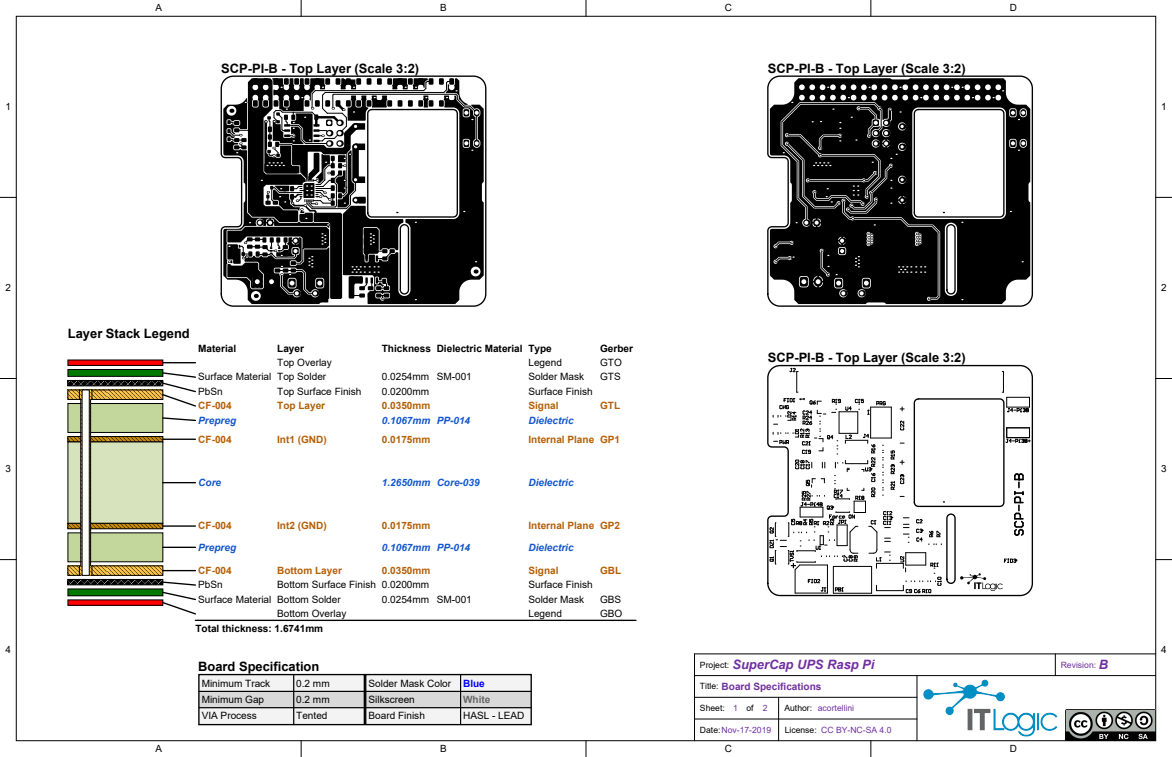
[picture p41: page 1]

SCP-PI-B - Top Layer (Scale 3:2)

Minimum Track | 0.2 mm | Solder Mask Color | Blue
Minimum Gap | 0.2 mm | Silkscreen | White
VIA Process | Tented | Board Finish | HASL - LEAD

License: CC BY-NC-SA 4.0

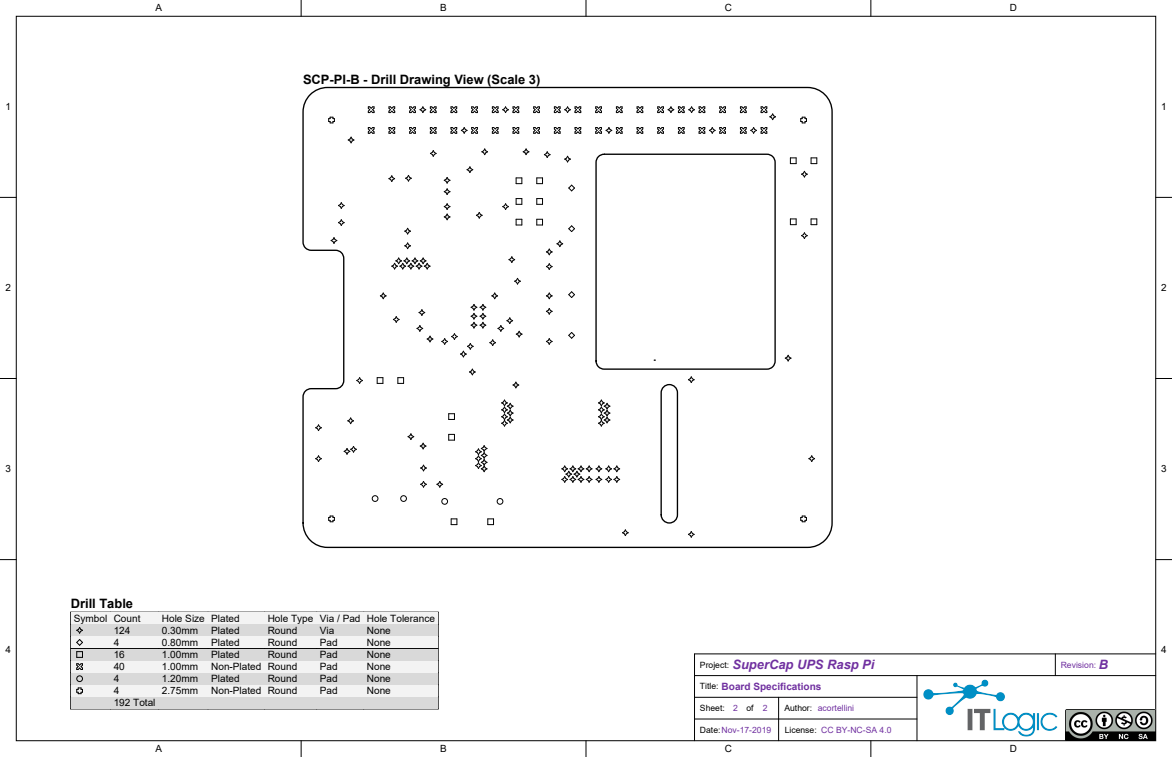
[picture p42: page 2]

SCP-PI-B - Drill Drawing View (Scale 3)

Symbol | Count | Hole Size | Plated | Hole Type | Via / Pad | Hole Tolerance

124 | 0.30mm | Plated | Round | Via | None
4 | 0.80mm | Plated | Round | Pad | None
16 | 1.00mm | Plated | Round | Pad | None
40 | 1.00mm | Non-Plated | Round | Pad | None
4 | 1.20mm | Plated | Round | Pad | None
4 | 2.75mm | Non-Plated | Round | Pad | None

License: CC BY-NC-SA 4.0
