alcor6502/SuperCap-UPS-RasPi-Altium/Documentation/Schematics/Schematic Prints.PDF

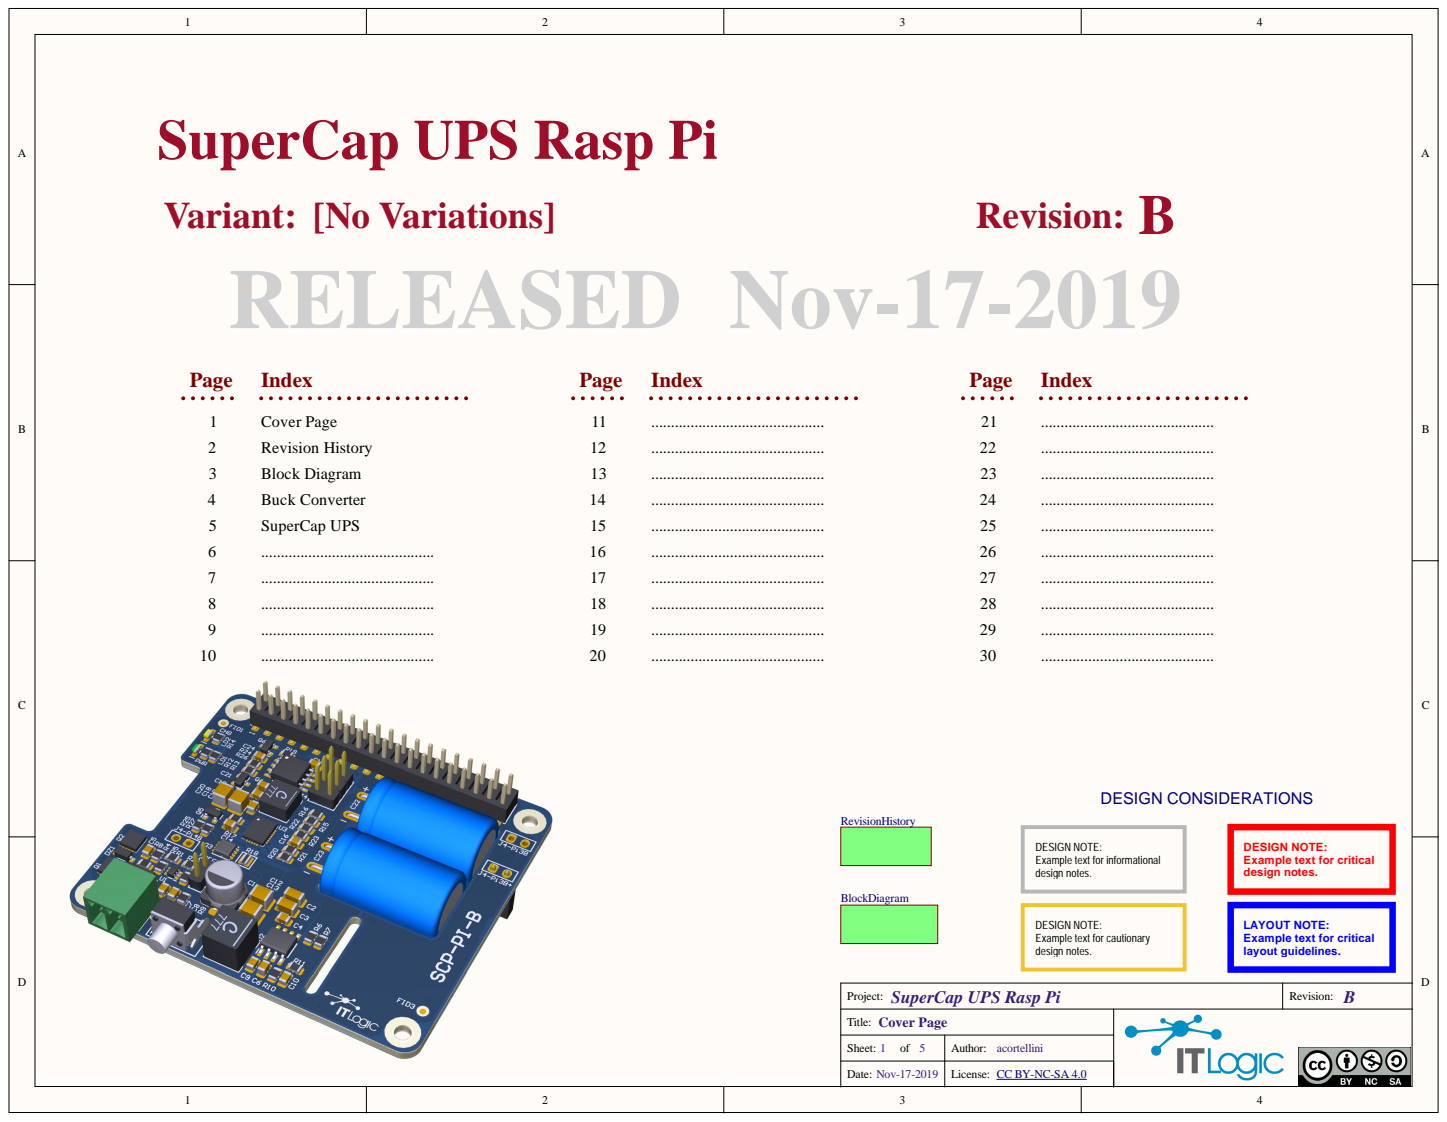
[picture p43: page 1]

SuperCap UPS Rasp Pi

DESIGN NOTE:
Example text for informational
design notes.

Example text for critical

Example text for cautionary

LAYOUT NOTE:
layout guidelines.

License: CC BY-NC-SA 4.0

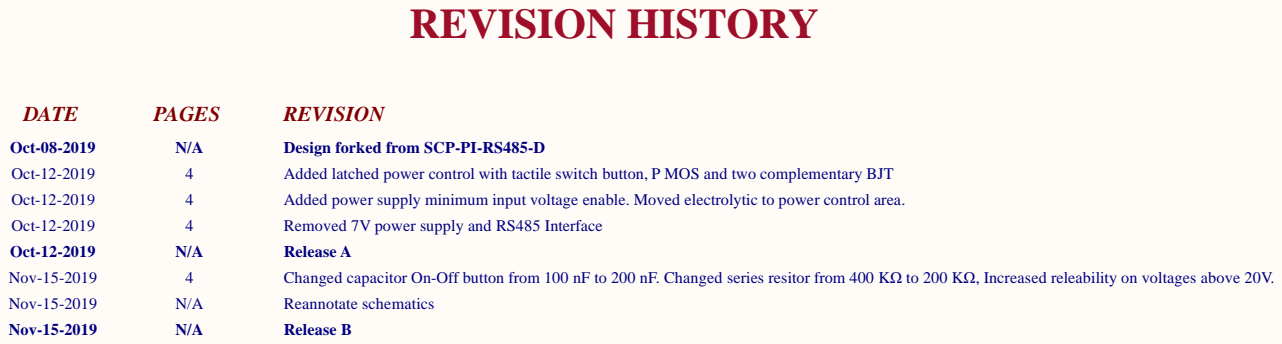
[picture p44: page 2]

Design forked from SCP-PI-RS485-D

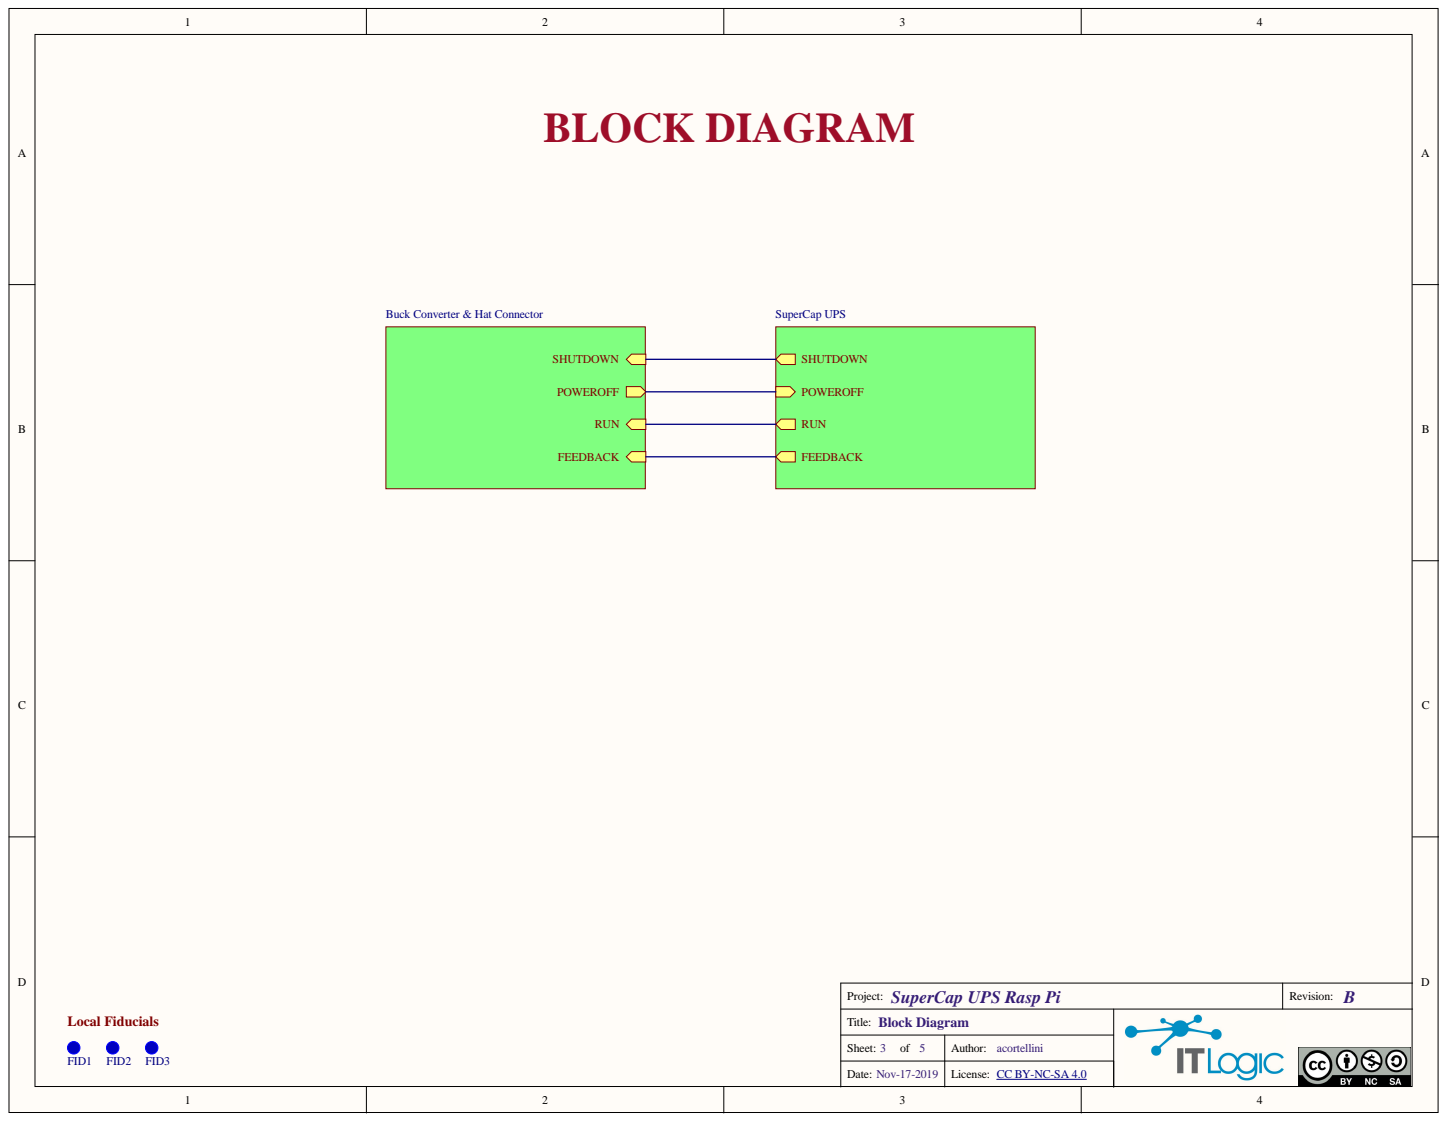
[picture p45: page 3]

Buck Converter & Hat Connector

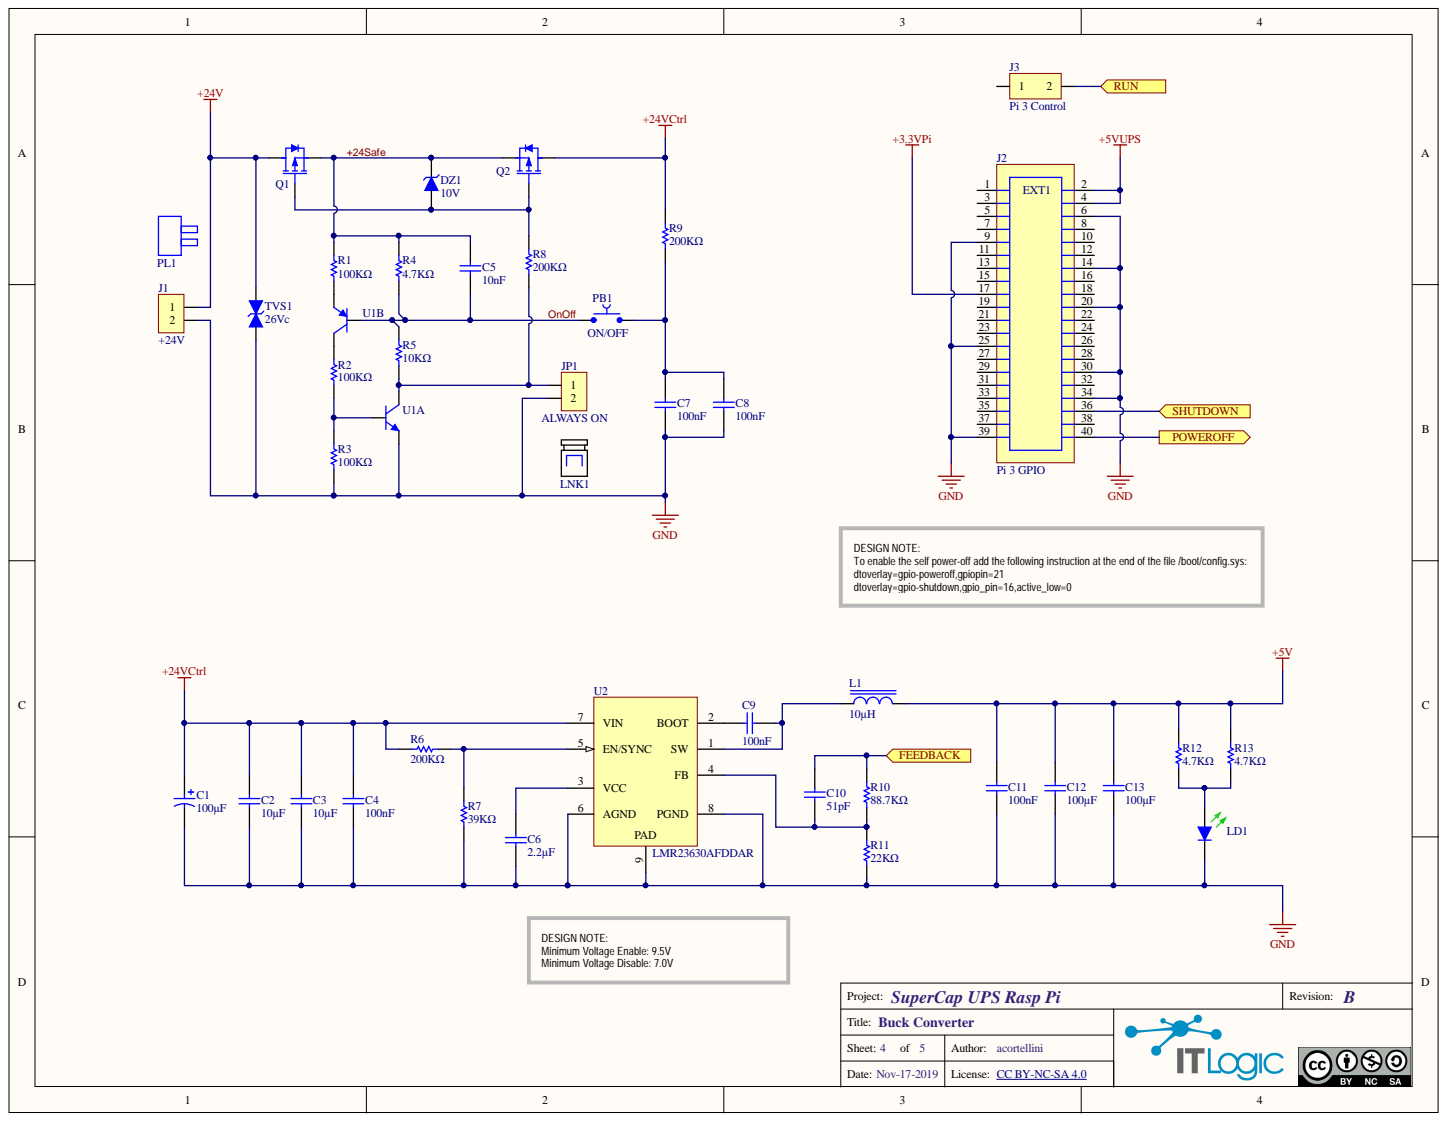
[picture p46: page 4]

9 | | 10
11 | | 12
13 | | 14
15 | | 16
17 | | 18

DESIGN NOTE:
To enable the self power-off add the following instruction at the end of the file /boot/config.sys:
dtoverlay=gpio-poweroff,gpiopin=21
dtoverlay=gpio-shutdown,gpio_pin=16,active_low=0

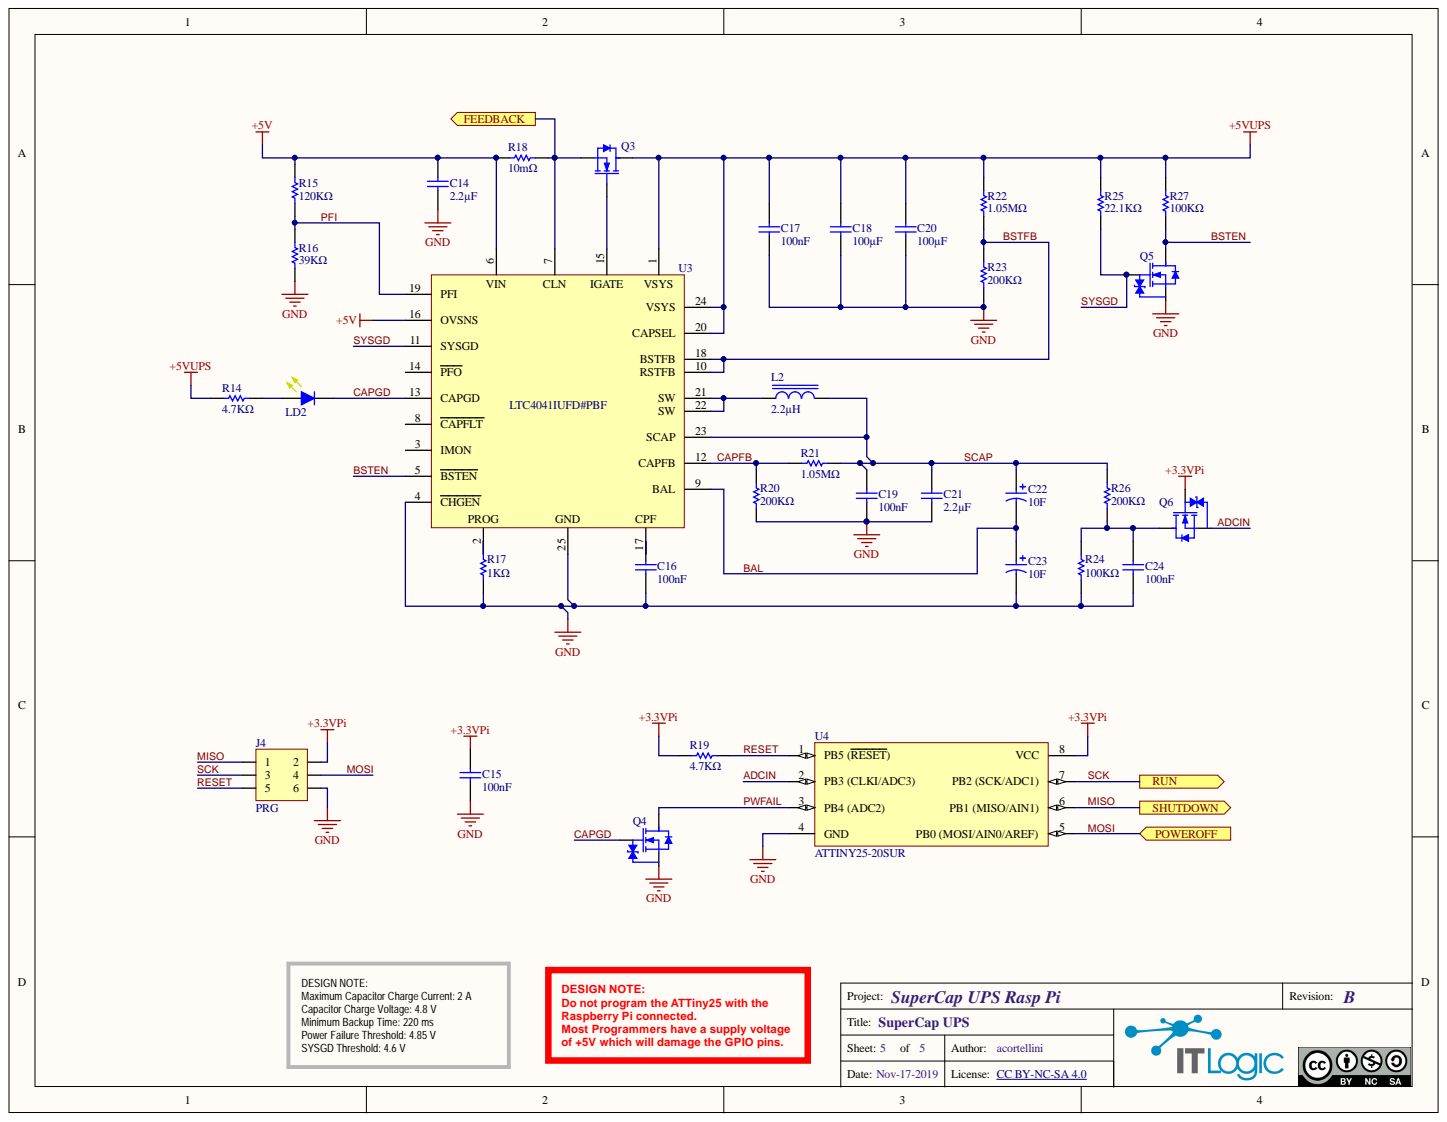
[picture p47: page 5]

VSYS PFI 19 OVSNS 16 LTC4041IUFD#PBF PROG GND CPF

DESIGN NOTE:
Maximum Capacitor Charge Current: 2 A
Capacitor Charge Voltage: 4.8 V
Minimum Backup Time: 220 ms
Power Failure Threshold: 4.85 V
SYSGD Threshold: 4.6 V

Do not program the ATTiny25 with the
Raspberry Pi connected.
Most Programmers have a supply voltage
of +5V which will damage the GPIO pins.
