alcor6502/SuperCap-UPS-RasPi-Altium/Documentation/Drawings/Board Dimensions.PDF

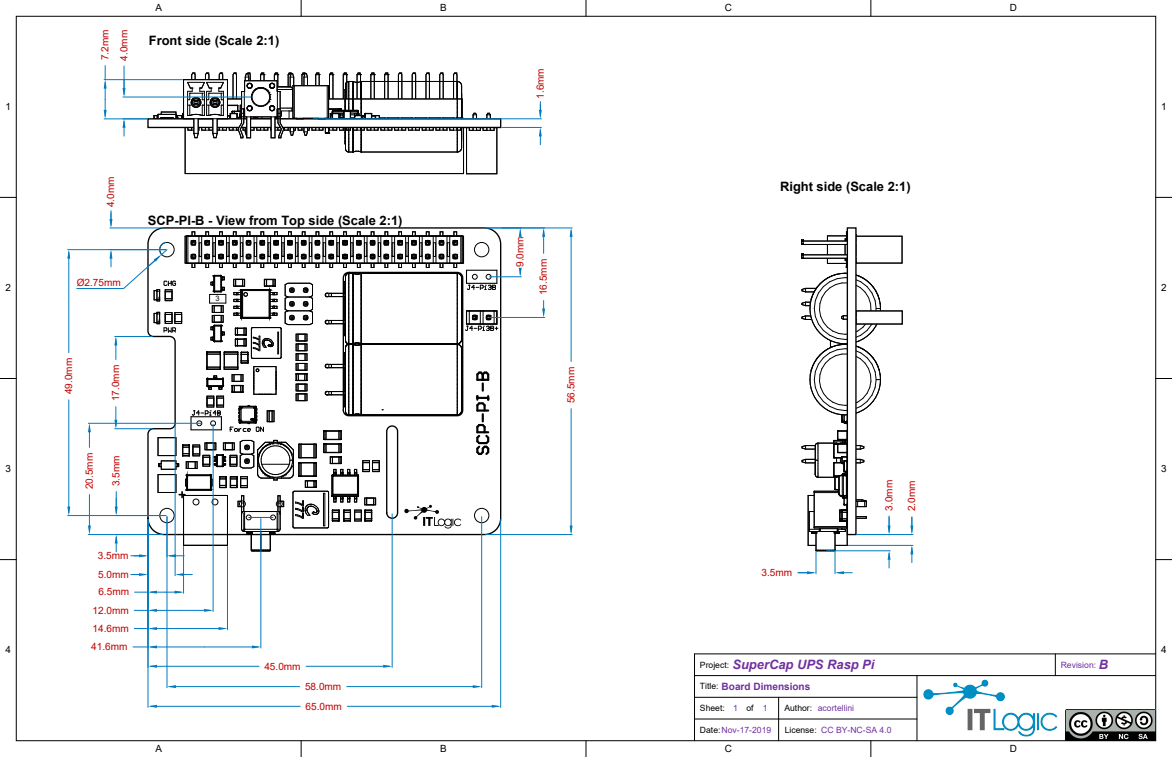
[picture p48: page 1]

SCP-PI-B - View from Top side (Scale 2:1)

License: CC BY-NC-SA 4.0
