alcor6502/SuperCap-UPS-RasPi-Altium/Documentation/Drawings/Panel Dimensions.PDF

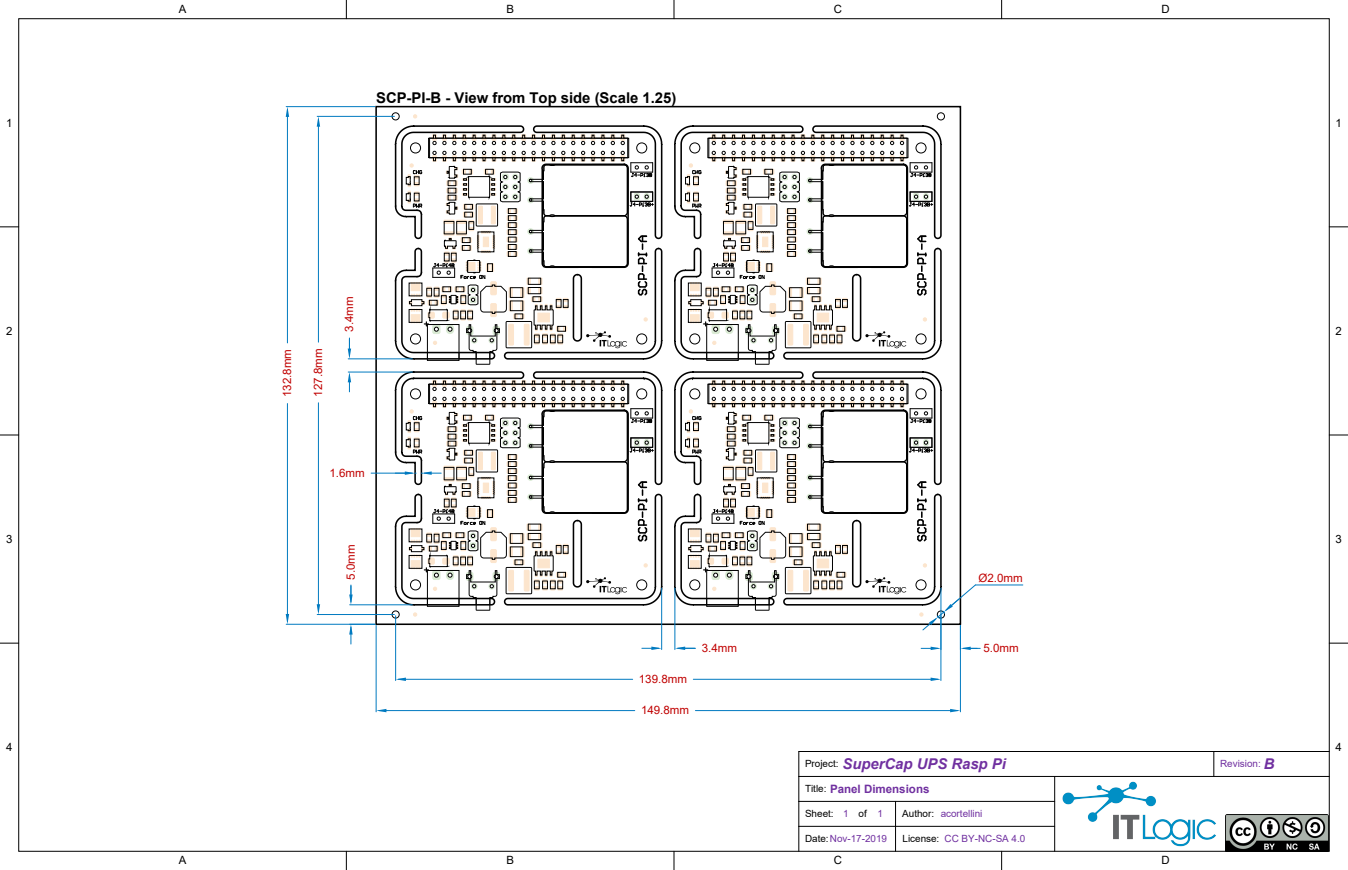
[picture p49: page 1]

SCP-PI-B - View from Top side (Scale 1.25)

License: CC BY-NC-SA 4.0
