alcor6502/SuperCap-UPS-RasPi-Altium/Documentation/Simulations/On-Off Switch.cir

[Main]
FileType=CIR
Version=12.00
Program=Micro-Cap
Component Version=10.00
Shape Version=11.00
Screen=1850,1103
MCAPVersion=12.2.0.2
Key ID=Demo
NLCnt=76
TXCnt=0

[shapedef]
Name=Bjt.root
Line=0,0,13,0
Rectangle=13,-12,15,12
Current=32,-24,32,-16
Current=32,24,32,16
Current=0,-8,8,-8
PolyOpen=3
PolyLine=24,-24
PolyLine=24,-12
PolyLine=14,-2
PolyOpen=3
PolyLine=24,24
PolyLine=24,12
PolyLine=14,2

[shapedef]
Name=Capacitor
Line=0,0,22,0
Line=22,-8,22,8
Line=26,-8,26,8
Line=26,0,48,0
Current=32,12,16,12

[shapedef]
Name=Diode.root
Line=0,0,20,0
Line=28,0,48,0
Rectangle=18,-8,20,8
PolyClosed=3
PolyLine=20,0
PolyLine=28,-8
PolyLine=28,8
Current=32,16,16,16

[shapedef]
Name=DPMOS
Root="Mos2.root",0,0,0
Line=14,0,24,0
PolyClosed=3
PolyLine=17,-3
PolyLine=17,3
PolyLine=20,0

[shapedef]
Name=Ground
Line=0,0,12,0
Line=12,-8,12,8
Line=18,-4,18,4
Line=24,0,24,0

[shapedef]
Name=Minus.root
Line=-2,0,2,0

[shapedef]
Name=Mos2.root
Line=0,8,10,8
Line=10,-8,10,8
Line=14,-11,14,-5
Line=14,-3,14,3
Line=14,5,14,11
Line=14,-8,24,-8
Line=14,8,24,8
Line=24,0,24,24
Line=24,-8,24,-24
Current=32,-24,32,-16
Current=32,24,32,16
Current=0,0,8,0

[shapedef]
Name=NPN
Root="Bjt.root",0,0,0
PolyClosed=3
PolyLine=20,12
PolyLine=24,12
PolyLine=24,8

[shapedef]
Name=Plus.root
Line=-2,0,2,0
Line=0,-2,0,2

[shapedef]
Name=PNP
Root="Bjt.root",0,0,0
PolyClosed=3
PolyLine=17,-5
PolyLine=21,-5
PolyLine=17,-9
Line=16,-4,14,-2
Line=16,4,14,2

[shapedef]
Name=Resistor
PolyOpen=12
PolyLine=0,0
PolyLine=0,0
PolyLine=12,0
PolyLine=14,-4
PolyLine=18,4
PolyLine=22,-4
PolyLine=26,4
PolyLine=30,-4
PolyLine=34,4
PolyLine=36,0
PolyLine=48,0
PolyLine=48,0
Current=32,8,16,8

[shapedef]
Name=SPICE_V
Root="Vsource.root",0,0,0

[shapedef]
Name=Switch
Line=0,0,0,0
Line=0,48,0,48
Line=48,0,48,16
Line=48,48,48,24
Line=48,16,52,20
Root="Plus.root",8,8,0
Root="Minus.root",8,40,0
Ellipse=-2,-2,2,2
FColor=None
Ellipse=-2,46,2,50
FColor=None

[shapedef]
Name=Vsource.root
Line=0,0,12,0
Line=36,0,48,0
Ellipse=12,-12,36,12
FColor=None
Line=7,5,7,9
Root="Plus.root",41,7,0
Current=32,16,16,16

[shapedef]
Name=Zener
Root="Diode.root",0,0,0
Rectangle=16,-9,20,-8
Rectangle=18,8,22,9

[compdef]
Name=Voltage Source
Definition=VSpice
Shape=SPICE_V
Mask=4865
Used=44
memo=Voltage Source
Label Offset=19,13,15,13
PinCnt=2
Pin="Plus",6,0,-5,-6
Pin="Minus",0,0,-20,-6

[compdef]
Name=Ground
Definition=Ground
Shape=Ground
Mask=1793
Used=259
memo=Ground
Label Offset=0,0,0,0
PinCnt=1
Pin="PinA",0,0,-3,-7

[compdef]
Name=2N3906
Definition=PNP
Shape=PNP
Mask=4226
Used=1
memo=PNP General Purpose Transistor Vceo=-40V Ic=-.2A Pd=625mW
Label Offset=29,-11,-6,26
PinCnt=3
Pin="Collector",3,3,5,0
Pin="Base",0,0,-19,-4
Pin="Emitter",3,-3,5,12
Power=0.625

[compdef]
Name=Resistor
Definition=Resistor
Shape=Resistor
Mask=6913
Used=165
memo=Resistor
Label Offset=18,6,8,11
PinCnt=2
Pin="Plus",6,0,-10,-4
Pin="Minus",0,0,-14,-4

[compdef]
Name=2N3904
Definition=NPN
Shape=NPN
Mask=4224
memo=NPN General Purpose Transistor Vceo=40V Ic=.2A Pd=625mW
Label Offset=29,-11,-6,26
PinCnt=3
Pin="Collector",3,-3,5,3
Pin="Base",0,0,-19,-3
Pin="Emitter",3,3,6,4
Power=0.625

[compdef]
Name=S (V-Switch)
Definition=S
Shape=Switch
Mask=4096
Used=12
memo=Voltage Controlled Switch
Label Offset=56,9,-27,51
PinCnt=4
Pin="Plus Output",6,0,-3,-3
Pin="Minus Output",6,6,-5,20
Pin="Plus Control",0,0,-33,-3
Pin="Minus Control",0,6,-41,20

[compdef]
Name=Capacitor
Definition=Capacitor
Shape=Capacitor
Mask=7425
Used=27
memo=Capacitor
Label Offset=16,12,12,12
PinCnt=2
Pin="Plus",6,0,-3,-5
Pin="Minus",0,0,-14,-5

[compdef]
Name=DMP6023LFG
Definition=Subckt
Shape=DPMOS
Mask=4224
Label Offset=30,-9,-5,27
PinCnt=3
Pin="10",a,3,-3,5,7
Pin="20",a,0,1,-6,-1
Pin="30",a,3,3,5,8

[compdef]
Name=BZD27C9V1
Definition=Diode
Shape=Zener
Mask=4224
memo=Zener Diode Vz=9.1V Izt=50mA
Link=http://www.vishay.com/docs/85810/bzd27c3v.pdf
Label Offset=16,11,16,11
PinCnt=2
Pin="Anode",6,0,-14,-2
Pin="Cathode",0,0,-26,-2

[Circuit]
Window Placement=0,1, -1,-1, -8,-31, -3,-1,873,854
Default Object=Color=#000080
Default Object Font=Height=-15,FStyle=0,Color=#000080,Name=Arial
Default Object Apply Border To Text=No
Default Object Apply Fill To Text=No
Default Object GridSnap=No
NodeVoltageFormat=3
CurrentFormat=3
PowerFormat=3
PathDelayFormat=3
WarningFormat=3
GridTextFormulaFormat=3
Window Placement in Transient Analysis=0,1, -1,-1, -8,-31, -1,3,1014,855
Window Placement in Transient Probe=0,1, -1,-1, -8,-31, 918,0,1836,855
SpiceType=AMBIGUOUS
Title_Block_Border=None
Title_Block=False
Show Nodes=True
Show Voltages=False
Show Current=False
Show Power=False
Show Condition=False
Show Pin Connections=False
Show Connection Warnings=False
Show Cross=False
Show Attribute Text=True
Show Grid Text=True

[Comp]
Name=Voltage Source
Px=32,248
Rot=5

[Attr]
ON=15,-27,PART
V=V1
Style=8192

[Attr]
ON=15,-41,VALUE
V=DC 0 AC 0 0 Pulse 0 6 500u 100n 100n 1000 10000

[Attr]
ON=0,0,PACKAGE
V

[Attr]
ON=0,0,SMOOTHING
V=N
Style=256

[Attr]
ON=0,0,Saved_PulseS
V=N
Style=256

[Attr]
ON=0,0,FRACTION
V=.2
Style=256

[Attr]
ON=0,0,Saved_PulseF
V=.2
Style=256

[Attr]
ON=0,0,Saved_Pulse
V=DC 0 AC 0 0 Pulse 0 38 500u 100n 100n 1000 10000
Style=256

[Attr]
ON=0,11,Saved_None
V=DC 9
Style=256

[Comp]
Name=Ground
Px=32,448
Rot=7

[Comp]
Name=2N3906
Px=168,240
Rot=6

[Attr]
ON=-45,-11,PART
V=Q1
Style=8192

[Attr]
ON=-29,3,MODEL
V=2N3906

[Attr]
ON=-29,17,POWER
V=0.625

[Attr]
ON=-29,45,PACKAGE
V=TO-92

[Comp]
Name=Resistor
Px=144,424
Rot=3

[Attr]
ON=-24,-25,PART
V=R2
Style=8192

[Attr]
ON=-39,-39,RESISTANCE
V=100k
Style=8192

[Attr]
ON=0,0,PACKAGE
V

[Comp]
Name=Resistor
Px=144,216
Rot=3

[Attr]
ON=-24,-25,PART
V=R3
Style=8192

[Attr]
ON=-39,-39,RESISTANCE
V=100k
Style=8192

[Attr]
ON=0,0,PACKAGE
V

[Comp]
Name=2N3904
Px=200,368

[Attr]
ON=-13,6,PART
V=Q2
Style=8192

[Attr]
ON=-29,-3,MODEL
V=2N3904

[Attr]
ON=-29,-17,POWER
V=0.625

[Attr]
ON=-29,-45,PACKAGE
V=TO-92

[Comp]
Name=Resistor
Px=144,312
Rot=5

[Attr]
ON=8,-25,PART
V=R4
Style=8192

[Attr]
ON=10,-39,RESISTANCE
V=0k
Style=8192

[Attr]
ON=0,0,PACKAGE
V

[Comp]
Name=Resistor
Px=224,312
Rot=3

[Attr]
ON=11,-22,PART
V=R5
Style=8192

[Attr]
ON=11,-37,RESISTANCE
V=10k
Style=8192

[Attr]
ON=0,0,PACKAGE
V

[Wire]
Pxs=32,432,144,432

[Comp]
Name=Resistor
Px=208,216
Rot=3

[Attr]
ON=-32,-25,PART
V=R6
Style=8192

[Attr]
ON=-32,-39,RESISTANCE
V=4.7k
Style=8192

[Attr]
ON=0,0,PACKAGE
V

[Wire]
Pxs=32,24,32,200

[Wire]
Pxs=144,432,224,432

[Wire]
Pxs=272,24,368,24

[Comp]
Name=S (V-Switch)
Px=280,288
Rot=3

[Attr]
ON=56,9,PART
V=S1
Style=8192

[Attr]
ON=56,23,MODEL
V=SW1

[Attr]
ON=0,0,PACKAGE
V

[Comp]
Name=Voltage Source
Px=280,384
Rot=5

[Attr]
ON=7,-5,PART
V=V2
Style=8192

[Attr]
ON=15,-41,VALUE
V=DC 0 AC 0 0 Pulse 0 10 10 500n 500n 2000m 20

[Attr]
ON=0,0,PACKAGE
V

[Attr]
ON=0,0,SMOOTHING
V=N
Style=256

[Attr]
ON=0,0,Saved_PulseS
V=N
Style=256

[Attr]
ON=0,0,FRACTION
V=.2
Style=256

[Attr]
ON=0,0,Saved_PulseF
V=.2
Style=256

[Attr]
ON=0,0,Saved_Pulse
V=DC 0 AC 0 0 Pulse 0 10 10 500n 500n 2000m 20
Style=256

[Comp]
Name=Resistor
Px=368,168
Rot=3

[Attr]
ON=-24,-25,PART
V=R7
Style=8192

[Attr]
ON=-39,-39,RESISTANCE
V=200k
Style=8192

[Attr]
ON=0,0,PACKAGE
V

[Comp]
Name=Capacitor
Px=368,384
Rot=5

[Attr]
ON=12,-26,PART
V=C2
Style=8192

[Attr]
ON=12,-40,CAPACITANCE
V=150n
Style=8192

[Attr]
ON=0,0,PACKAGE
V

[Comp]
Name=Resistor
Px=88,144
Rot=3

[Attr]
ON=-24,-25,PART
V=R8
Style=8192

[Attr]
ON=-43,-39,RESISTANCE
V=200k
Style=8192

[Attr]
ON=0,0,PACKAGE
V

[Comp]
Name=Resistor
Px=424,200
Rot=7

[Attr]
ON=-30,10,PART
V=R9
Style=8192

[Attr]
ON=-30,23,RESISTANCE
V=100
Style=8192

[Attr]
ON=0,0,PACKAGE
V

[Comp]
Name=DMP6023LFG
Px=80,48
Rot=3

[Attr]
ON=-27,-11,PART
V=X1
Style=8192

[Attr]
ON=30,5,NAME
V=DMP6023LFG

[Attr]
ON=0,0,PACKAGE
V

[Wire]
Pxs=248,24,272,24

[Wire]
Pxs=464,248,464,432

[Wire]
Pxs=104,24,144,24

[Wire]
Pxs=240,48,240,72

[Comp]
Name=BZD27C9V1
Px=208,24
Rot=1

[Attr]
ON=-32,16,PART
V=D2
Style=8192

[Attr]
ON=16,25,MODEL
V=BZD27C9V1

[Attr]
ON=16,53,PACKAGE
V=DO-219AB

[Comp]
Name=DMP6023LFG
Px=248,48
Rot=5

[Attr]
ON=10,-9,PART
V=X2
Style=8192

[Attr]
ON=-30,5,NAME
V=DMP6023LFG

[Attr]
ON=0,0,PACKAGE
V

[Wire]
Pxs=144,424,144,432

[Wire]
Pxs=144,312,144,368

[Wire]
Pxs=144,368,200,368

[Wire]
Pxs=208,24,224,24

[Wire]
Pxs=88,72,208,72

[Wire]
Pxs=208,72,240,72

[Wire]
Pxs=224,216,224,240

[Wire]
Pxs=224,216,240,216

[Wire]
Pxs=208,168,224,168

[Wire]
Pxs=208,216,224,216

[Wire]
Pxs=144,144,144,168

[Wire]
Pxs=224,144,224,168

[Wire]
Pxs=224,168,240,168

[Wire]
Pxs=144,144,224,144

[Wire]
Pxs=144,24,144,144

[Wire]
Pxs=144,24,208,24

[Wire]
Pxs=224,432,280,432

[Wire]
Pxs=168,240,224,240

[Wire]
Pxs=88,328,224,328

[Wire]
Pxs=32,24,56,24

[Wire]
Pxs=88,48,88,72

[Wire]
Pxs=88,72,88,96

[Wire]
Pxs=88,144,88,328

[Wire]
Pxs=144,368,144,376

[Wire]
Pxs=224,328,224,344

[Wire]
Pxs=224,392,224,432

[Wire]
Pxs=328,288,328,432

[Wire]
Pxs=328,432,368,432

[Wire]
Pxs=328,240,368,240

[Wire]
Pxs=368,240,368,336

[Wire]
Pxs=368,384,368,432

[Wire]
Pxs=368,432,424,432

[Wire]
Pxs=368,168,368,240

[Wire]
Pxs=368,24,368,120

[Wire]
Pxs=224,240,280,240

[Wire]
Pxs=368,24,424,24

[Wire]
Pxs=424,24,424,200

[Wire]
Pxs=424,24,464,24

[Wire]
Pxs=424,248,424,432

[Wire]
Pxs=424,432,464,432

[Wire]
Pxs=32,432,32,448

[Wire]
Pxs=32,248,32,432

[Wire]
Pxs=224,240,224,264

[Wire]
Pxs=224,312,224,328

[Wire]
Pxs=280,288,280,336

[Wire]
Pxs=280,384,280,432

[Wire]
Pxs=280,432,328,432

[Wire]
Pxs=464,24,464,200

[Comp]
Name=Capacitor
Px=240,216
Rot=5

[Attr]
ON=12,-26,PART
V=C4
Style=8192

[Attr]
ON=12,-40,CAPACITANCE
V=10n
Style=8192

[Attr]
ON=0,0,PACKAGE
V

[Comp]
Name=Capacitor
Px=464,248
Rot=5

[Attr]
ON=12,-26,PART
V=C5
Style=8192

[Attr]
ON=12,-40,CAPACITANCE
V=100u
Style=8192

[Attr]
ON=0,0,PACKAGE
V

[Schematic]
CurrentSection 0=0
CurrentSection 1=0
CurrentSection 2=0
CurrentSection 3=0
Splitter.xs=0
Splitter.ys=0
TextQuad=4099
Scale=0.66666666666666663
GridUser=10
ShapeGroups="Main","Euro","Polarity","Main1","Main11","Electrolytic","GroundArrow","DeMorgan"
CalcRMS=False
CalcAVG=False
CalcPeak=False
CalcVoltage=True
DisplayMeasure=Last
ShareScales=True

[Tools]
Pos=Top
FILESAVEASOLD=No
BOM=No
FILEPCB=No
PROBE=Yes
SELECT=Yes
PAN=Yes
COMP=Yes
TEXT=Yes
WIRE=Yes
WIRED=Yes
BUS=Yes
GRAPHIC=Yes
FLOWCHART=Yes
LINE=No
ELLIPSE=No
RECT=No
DIAM=No
ARC=No
PIE=No
TRIANGLE=No
STAR=No
LEFTBRK=No
RIGHTBRK=No
BOTHBRK=No
META=Yes
PARALLELOGRAM=No
FC_PROCESS=No
FC_ALT_PROCESS=No
FC_DECISION=No
FC_DATA=No
FC_PREDEFPROCESS=No
FC_INTERNALSTORAGE=No
FC_DOCUMENT=No
FC_MULTIDOCUMENT=No
FC_TERMINATOR=No
FC_PREPARATION=No
FC_MANUALINPUT=No
FC_MANUALOPERATION=No
FC_CONNECTOR=No
FC_OFFPAGECONNECTOR=No
FC_PUNCHCARD=No
FC_PUNCHEDTAPE=No
FC_SUMMING_JUNCTION=No
FC_OR=No
FC_COLLATE=No
FC_SORT=No
FC_EXTRACT=No
FC_MERGE=No
FC_STORED_DATA=No
FC_DELAY=No
FC_SAS=No
FC_MAGNETIC_DISK=No
FC_DAS=No
FC_DISPLAY=No
SPREAD_SHEET=Yes
POLYCLOS=No
POLYOPEN=No
FLAG=Yes
INFO=Yes
HELP=Yes
HELP_SPICE=No
LINK=Yes
CHECK=Yes
REGION_ENABLE=Yes
TITLE_BLOCK=Yes
DIGTRC=No
DIGTRC2=No
BUILD_COMMAND=Yes
DIGALL=No
GRIDTEXT=Yes
COMPTEXT=Yes
NODE=Yes
MEASURED=Yes
NODEV=Yes
CURRENT=Yes
POWER=Yes
CONDITIN=Yes
PIN=Yes
CONNWARN=Yes
CROSS=No
GRID=Yes
BORDER=Yes
BORDERONE=Yes
TITLE=Yes
RUBBER=Yes
PROPERTY=Yes
STEP=Yes
MIRROR=Yes
ROTATE=Yes
FLIPY=Yes
FLIPX=Yes
CIR_MAKEMACRO=No
CLEARCUTWIRE=No
CLIPBOARDCIRPAGE2BMM=No
FINDCOMP=Yes
FIND=Yes
REPEAT=No
REPLACE=No
MODEL=Yes
CIR2CKT=No
ATTDISP=No
ENABLE=Yes
DISABLE=Yes
ENABLE_WITH=Yes
TOFRONT=Yes
TOBACK=Yes
SELNEXT=No
PAGEADD=No
PAGEADDTEXT=No
ADDSECTION=No
PAGEDEL=No
ZOOMIN=Yes
ZOOMOUT=Yes
AUTOSCALECIR=Yes
GOTOFLAG=No
UPLEVEL=Yes
COLOR=Yes
FONT=Yes
STYLE=Yes
DM_LAST=No
DM_RMS=No
DM_AVG=No
DM_PEAK=No
GRID_NONE=No
GRID_NORMAL=No
GRID_BOLD_5=No
GRID_BOLD_6=No
GRID_BOLD_USER=No
GRAPH_PAPER=No
SPLITCIRTEXTH=No
SPLITCIRTEXTV=No
SPACE_SPLITTERS_EVENLY=No
NORMALCIR=No
RENAMEDEFINE=No
RENAMECMP=No
ATTALIGN=No
RESETNODEPOS=No
FIT2STANDARD=No
NODESNAP=No
MOVETEXT=No
TEXTINC=No
TOGGLETEXT=No
TOGGLEMODE=No
TOLERANCE=No
ALIGNAB=No
ALIGNLEFT=No
ALIGNCENTER=No
ALIGNRIGHT=No
ALIGNTOP=No
ALIGNMIDDLES=No
ALIGNBOTTOM=No

[Section]
Index=0
Name="On-Off Switch"
Type=Main
Enable=True
CurrentPage 0=0
CurrentPage 1=0
CurrentPage 2=0
CurrentPage 3=0
TabSize 0=425
TabSize 1=425
TabSize 2=425
TabSize 3=425

[Page]
Index=0
Section=0
Print=True
Enable=True
Name=Main
PrinterScale=1
Scale 0=1
Scale 1=1
Scale 2=1
Scale 3=0.66666666666666663
Px=477,16
WinBackGround Color=#FFFFFF
Select Color=#FF0000
Anchor Color=#000000
Select Box Color=#000080
Grid Text Color=Height=-12,FStyle=0,Color=#0000FF,Name=Verdana
Grid Text RTF=False
Grid Text Angle=0
Grid Text GridSnap=True
Grid Text PinIt=False
Grid Text JustifyH=Left
Grid Text JustifyV=Bottom
Grid GradientColor2=None
Grid OutlineThickness=1
Grid OutlineColor=None
Component Color=#0000FF
Attribute Text=Height=-12,FStyle=0,Color=#008000,Name=Verdana
Wire Color=#008000
Bus Color=#008000
Pin Connection=Height=-10,FStyle=0,Color=#FF0000,Name=Arial
Pin Marker Color=#008000
Node Number=Height=-11,FStyle=0,Color=#FF00FF,Name=Arial
Node Voltage Color=Height=-11,FStyle=0,Color=#000000,Name=Arial
Dynamic AC Voltage Color=#E4E4E4
Text Banner Text=Height=-15,FStyle=0,Color=#800000,Name=Arial
Title Block Background=#C0C0C0
Current=Height=-11,FStyle=0,Color=#0000FF,Name=Arial
Power/Condition=Height=-11,FStyle=0,Color=#FF0000,Name=Arial
Digital Path Color=#FF0000
Title Block Border=#000000
Disabled	Color=#C0C0C0
Search Color=#FFFF00
Grid Color=#000000
Graph Paper=#E4E4E4
Digital 0 Color=#000000
Digital R Color=#FFFF00
Digital F Color=#FFFF00
Digital 1 Color=#FF0000
Digital X Color=#C0C0C0
Digital Z Color=#808080
Block Select Color=#51F998

[Page]
Index=1
Section=0
Type=Text
Print=False
Enable=True
Name=Text
Font=Height=-15,FStyle=0,Color=#000000,Name=Courier New
Comment Color=#008000
WinBackGround Color=#FFFFFF
Disabled	Color=#C0C0C0
KeyWord Color=#0000FF
Error	Color=#FF0000
Search Color=#FFFF00

[Page]
Index=2
Section=0
Type=Text
Print=False
Enable=True
Name=Models
Font=Height=-15,FStyle=0,Color=#000000,Name=Courier New
Comment Color=#008000
WinBackGround Color=#FFFFFF
Disabled	Color=#C0C0C0
KeyWord Color=#0000FF
Error	Color=#FF0000
Search Color=#FFFF00

[Page]
Index=3
Section=0
Type=Info
Print=False
Enable=True
Name=Info
Font=Height=-15,FStyle=0,Color=#000000,Name=Courier New
Comment Color=#008000
WinBackGround Color=#FFFFFF
Disabled	Color=#C0C0C0
KeyWord Color=#0000FF
Error	Color=#FF0000
Search Color=#FFFF00

[Text Area]
Section=0
Page=1
Text=.OPTIONS ITL4=50

[Text Area]
Section=0
Page=2
Text=* Schematic File
Text=*
Text=* Syntax:
Text=* .MODEL <model name> [AKO:<reference model name>] <ModelType>
Text=* +([<parameter name>=<value>][LOT[/#][/GAUSS|/UNIFORM|/WCASE]=[<tol>[%]] |[-<low>%,<high>%]][DEV[/#][/GAUSS|/UNIFORM|/WCASE]=[<tol>[%]]...)
Text=* ModelType must be one of OPA,D,NPN,NMOS,NJF,PUL,SIN,TRN,CORE,GASFET,VSWITCH,ISWITCH,CAP,IND,RES,PNP,PMOS,PJF,DOUTPUT,DINPUT,UADC,UDAC,UGATE,UTGATE,UEFF,UGFF,UDLY,UPLD,UROM,URAM,UBGT,UIO,LPNP,NIGBT,I,V
Text=*
Text=*Examples:
Text=* .MODEL 2N2222A NPN(BF=150 IS=1E-14)
Text=* .model M1 NMOS(KP=2.5E-5 VTO=1.345 CGDO=14.67p CGBO=4.566p)
Text=* .MODEL DK D(IS=1E-18)
Text=* .model 2N2222A AKO:2N2222 NPN (BF=55 ISE=10F)
Text=* .Model BJT1 NPN (RE=12 LOT/1/GAUSS=30% DEV/2/UNIFORM=2%)
Text=*
Text=* A .cir file is typically found in the data directory
Text=*
Text=*** From file C:\MC12\library\ON_SEMI.LIB
Text=.MODEL NMOS VSWITCH (ROFF=1E6 RON=0.3 VOFF=0.0 VON=1.0)
Text=*** From file C:\MC12\library\ON_SEMI.LIB
Text=.MODEL PMOS VSWITCH (ROFF=1E6 RON=0.3 VOFF=0.0 VON=1.0)
Text=*** From file C:\MC12\library\ON_SEMI.LIB
Text=.MODEL SW1 VSWITCH (ROFF=100MEG RON=0.0001 VOFF=0.0 VON=10)
Text=*** From file C:\MC12\library\ON_SEMI.LIB
Text=.MODEL SW2 VSWITCH (RON=.11 VOFF=.31 VON=0.3)
Text=*** From file C:\MC12\library\ON_SEMI.LIB
Text=.MODEL SVCC VSWITCH (VH=.04 VT=3.91)
Text=*** From file C:\MC12\library\APPLICATION.LIB
Text=.MODEL SBREAK VSWITCH (ROFF=100 RON=10 VOFF=0.0 VON=1.0)
Text=*** From file C:\MC12\library\ON_SEMI.LIB
Text=.MODEL SBREAKON VSWITCH (ROFF=1E9 RON=0.001 VOFF=0.0 VON=1.0)
Text=*** From file C:\MC12\library\APPLICATION.LIB
Text=.MODEL SBREAK2 VSWITCH (ROFF=1E6 RON=10M VOFF=0.0 VON=1.0)
Text=*** From file C:\MC12\library\ON_SEMI.LIB
Text=.MODEL BREAKEN VSWITCH (ROFF=1000E6 RON=1.0 VOFF=0.0 VON=1.0)

[InfoPage]
InfoPage=True
Warnings=True
System=True
Defines=True
Array=True
Model=True
Measure=True
MacroSubckt=True
NotUsed=True
ComponentCounts=True
VariablizePaths=False
DontShowPaths=False
SimulationLog=True

[Transient]
WinID=1
Window Placement=0,1, -1,-1, -8,-31, 1033,4,1783,827
Font=Height=-19,FStyle=0,Color=#0000FF,Name=Arial
WinBackGround Color=#FFFFFF
Select Color=#FF0000
Anchor Color=#000000
Select Box Color=#000080
Window Placement in Probe=0,1, -1,-1, -1,-1, 0,0,918,855
Title=On-Off New.cir
AutoTitle=Yes
Grid Color=#808080
Grid Weight=1
Grid Pattern=Dot6
Tracker Foreground=Height=-15,FStyle=0,Color=#000000,Name=Arial
Tracker Background=#FFFF00
Baseline color=#0000FF
BaseLine Weight=1
CurveFit color=#FF0000
CurveFit Weight=2
CurveFit Pattern=Dash
Static Grids=False
PlusMark=False
MinorLog25=Off
LabelMinor=Off
DataPoints=False
Token=False
Ruler=False
XAxisGrids=True
YAxisGrids=True
MinorLogGrids=True
BaseLine=False
AlignZ=True
Align Cursors=True
TagFormatX=3
TagFormatY=3
FormulaFormat=2
EndMode=SCALE
Graph Background=#FFFFFF
Tracker Intercept=False
Tracker Mouse=True
Tracker Cursor=True
Tracker Cursor BranchInfo=False
Horizontal Cursor=False
Same Y Scales=Yes
Enable X Scaling=True
Enable Y Scaling=False
Keep X Scales The Same=True
Number of Grids X=5
Number of Grids Y=5
Cursor Select Color Primary=#C0C0C0
Cursor Select Color Secondary=#FF0000
Data Point Labels Color Fore=Height=-15,FStyle=0,Color=#000000,Name=Arial
Data Point Labels Color Back=#FFFF00
OperPoint=True
OperPointOnly=False
AutoScaleRanges=True
FixedTimeStep=False
DoPSS=False
PSS_Periods="1"
PSS_Iterations="5"
PSS_Error="1u"
PSS_ShowPlots=True
FFT_NPts="8192"
FFT_IncludeDCHarmonic=False
FFT_AutoScale_Harmonics="10"
PrinterAutoTile=No
PrinterBlackBorder=No
MonMaxShow=14
MonPageWidth=42
MonPlotWidth=26
MonExprXWidth=96
MonExprYWidth=172
MonRangeXWidth=101
MonRangeYWidth=180
AnimateWait=None
AnimateWaitTime=500
AnimatePressAfter=0
Save_For_Future=No
Reduce_Display=1
Reduce_Save=1
Reduce_ThrowDataOut=0
Num Out Header Left
Num Out Header Center="$MC\n$user\n$company\n$Analysis of $name\n$date $time"
Num Out Header Right
Num Out Delimiter=32
Num Out Write=True
Num Out Write Main Header=True
Num Out Write Limits=True
Num Out Write Branch Header=True
Num Out Write Models=False
Num Out Write Zero Models=True
Num Out Write Undefined Models=True
Num Out Write Operating Point=True
Num Out Write Measurement Values=True
Num Out Write Tolerance Detail=True
Num Out Write Values=True
Num Out Write Waveform Header=True
Num Out Allow Dup Y Expr=False
Num Out Low="TSTART"
Num Out High="TMAX"
Num Out Font=Height=-15,FStyle=0,Color=#000000,Name=Courier New
Num Out Format=3
Num Out HideNonSelected=False
Num Out UseActualDataPoints=False
AutoSaveWave=False
Wave Format=16E
State Variables Format=5E
Print Individual Pages=False

[Tools]
Pos=Top
SELECT=Yes
PAN=Yes
GRAPHIC=Yes
LINE=No
ELLIPSE=No
RECT=No
DIAM=No
ARC=No
PIE=No
TRIANGLE=No
STAR=No
LEFTBRK=No
RIGHTBRK=No
BOTHBRK=No
META=Yes
PARALLELOGRAM=No
POLYCLOS=No
POLYOPEN=No
SCALE=Yes
CURSOR=Yes
MEASUREH=Yes
MEASUREV=Yes
TAG=Yes
PTAG=Yes
TEXT=Yes
PROPERTY=Yes
START=Yes
STOP=Yes
PAUSE=Yes
RESUME=No
DATAPTS=Yes
TOKENS=Yes
RULER=Yes
PLUS=Yes
XAXIS=Yes
YAXIS=Yes
MINORLOG=Yes
LOG25=Yes
BASELINE=Yes
HORIZCUR=Yes
GOTOX=Yes
GOTOY=Yes
GOTOPERF=Yes
GOTOBRNC=Yes
CLEAR_ACCUMULATED=Yes
PDELETE_ALL_PLOTS=Yes
NEXT=Yes
NEXTIN=Yes
PEAK=Yes
VALLEY=Yes
HIGH=Yes
LOW=Yes
INFLECTN=Yes
GHIGH=Yes
GLOW=Yes
BOTTOM=Yes
TOP=Yes
WAVEFORMBUFFER=Yes
AOUTPUT=Yes
PKEY=Yes
ENXSCALE=Yes
ENYSCALE=Yes
ZOOMIN=Yes
ZOOMOUT=Yes
AUTOSCALE=Yes
RESTORESCALE=No
COLOR=Yes
FONT=Yes
STYLE=Yes
SELNEXT=No
NORMALIZE=No
NORMALIZE_MIN=No
NORMALIZE_MAX=No
ADD_TAG_LEFT=No
ADD_TAG_RIGHT=No
ADD_HORZ_TAG=No
ADD_VERT_TAG=No
ALIGN_CURSORS=No
ALIGN_CURSORSZ=No
CURSORTOCLIPBOARD=No
TRACKER_CURSOR=No
TRACKER_CURSOR_BRANCHINFO=No
TRACKER_INTERCEPT=No
TRACKER_MOUSE=No
TOFRONT=Yes
TOBACK=Yes
SPLITCIRTEXTH=No
SPLITCIRTEXTV=No
SPACE_SPLITTERS_EVENLY=No
NORMALCIR=No
LABEL_WAVEFORM=No
LABEL_DATA_POINTS=No
WFB_ADD_TO_LIMITS=No
ENVELOPE=No
SAMEYSCALES=No
KEEPXSCALESTHESAME=No
CURVEFIT=No
ADD_MARKER=No
SHOWWATCH=No
BP=No
TOGGLEMODE=No
REMOVEALLTEXT=No
AUTOSCALEX=No
LABELALLMINOR=No
ALIGNLEFT=No
ALIGNCENTER=No
ALIGNRIGHT=No
ALIGNTOP=No
ALIGNMIDDLES=No
ALIGNBOTTOM=No

[APage]
Analysis=Transient
Name="MAIN"

[Monte Carlo Options]
Analysis=Transient
Status=Off
Zero Tolerance=False
Eliminate Outliers=False
Distribution=Normal
Number of Runs=10
Seed=0

[Limits]
Analysis=Transient
TMax=100
TStart=490u
TStep=0.001
NPts=10000
Temp=27
RetraceRuns=1
StateVar=Zero
RunOption=Normal
Temperature Type=Linear
Accumulate Plots=False
IgnoreExprErrors=False

[WaveForm]
Analysis=Transient
Plt=1
AliasID=1
XExp=T
YExp=v(1)
XRng=AutoAlways
YRng=30
Options=LINEARX,LINEARY
Range Grid Y=6
Enable=DontRun
Line Color=#0000FF
Text Color=#0000FF
Rainbow=False
VFmtX=3
VFmtY=3
ScaleFactorX="None"
ScaleFactorY="None"
ScaleUnitsX="Auto"
ScaleUnitsY="Auto"
SFmtX=2
SFmtY=2
NOFmtX=3E
NOFmtY=3E

[WaveForm]
Analysis=Transient
Plt=1
AliasID=14
XExp=T
YExp=i(v1)
XRng=AutoAlways
YRng=75,-50
Options=LINEARX,LINEARY
Range Grid Y=25
Enable=DontRun
Line Color=#FF0000
Text Color=#FF0000
Rainbow=False
VFmtX=3
VFmtY=3
ScaleFactorX="None"
ScaleFactorY="None"
ScaleUnitsX="Auto"
ScaleUnitsY="Auto"
SFmtX=2
SFmtY=2
NOFmtX=3E
NOFmtY=3E

[WaveForm]
Analysis=Transient
Plt=1
AliasID=2
XExp=T
YExp=v(9)
XRng=AutoAlways
YRng=16,-4
Options=LINEARX,LINEARY
Range Grid Y=4
Enable=DontRun
Line Color=#FF0000
Text Color=#FF0000
Rainbow=False
VFmtX=3
VFmtY=3
ScaleFactorX="None"
ScaleFactorY="None"
ScaleUnitsX="Auto"
ScaleUnitsY="Auto"
SFmtX=2
SFmtY=2
NOFmtX=3E
NOFmtY=3E

[WaveForm]
Analysis=Transient
Plt=1
AliasID=4
XExp=T
YExp=v(10)
XRng=AutoAlways
YRng=8
Options=LINEARX,LINEARY
Range Grid Y=1.6
Enable=Enable
Line Color=#008000
Text Color=#008000
Rainbow=False
VFmtX=3
VFmtY=3
ScaleFactorX="None"
ScaleFactorY="None"
ScaleUnitsX="Auto"
ScaleUnitsY="Auto"
SFmtX=2
SFmtY=2
NOFmtX=3E
NOFmtY=3E

[WaveForm]
Analysis=Transient
Plt=1
AliasID=3
XExp=T
YExp=v(1)-v(11)
XRng=AutoAlways
YRng=60,-40
Options=LINEARX,LINEARY
Range Grid Y=20
Enable=Hide
Line Color=#FF00FF
Text Color=#FF00FF
Rainbow=False
VFmtX=3
VFmtY=3
ScaleFactorX="None"
ScaleFactorY="None"
ScaleUnitsX="Auto"
ScaleUnitsY="Auto"
SFmtX=2
SFmtY=2
NOFmtX=3E
NOFmtY=3E

[WaveForm]
Analysis=Transient
Plt=1
AliasID=5
XExp=T
YExp=i(r6)
XRng=AutoAlways
YRng=60,-40
Options=LINEARX,LINEARY
Range Grid Y=20
Enable=Hide
Line Color=#000000
Text Color=#000000
Rainbow=False
VFmtX=3
VFmtY=3
ScaleFactorX="None"
ScaleFactorY="None"
ScaleUnitsX="Auto"
ScaleUnitsY="Auto"
SFmtX=2
SFmtY=2
NOFmtX=3E
NOFmtY=3E

[WaveForm]
Analysis=Transient
Plt=1
AliasID=6
XExp=T
YExp=i(r3)
XRng=AutoAlways
YRng=4.8e-5,-1.2e-5
Options=LINEARX,LINEARY
Range Grid Y=1.2e-5
Enable=DontRun
Line Color=#0000FF
Text Color=#0000FF
Rainbow=False
VFmtX=3
VFmtY=3
ScaleFactorX="None"
ScaleFactorY="None"
ScaleUnitsX="Auto"
ScaleUnitsY="Auto"
SFmtX=2
SFmtY=2
NOFmtX=3E
NOFmtY=3E

[WaveForm]
Analysis=Transient
Plt=1
AliasID=7
XExp=T
YExp=v(3)
XRng=AutoAlways
YRng=60,-40
Options=LINEARX,LINEARY
Range Grid Y=20
Enable=Hide
Line Color=#FF0000
Text Color=#FF0000
Rainbow=False
VFmtX=3
VFmtY=3
ScaleFactorX="None"
ScaleFactorY="None"
ScaleUnitsX="Auto"
ScaleUnitsY="Auto"
SFmtX=2
SFmtY=2
NOFmtX=3E
NOFmtY=3E

[WaveForm]
Analysis=Transient
Plt=1
AliasID=8
XExp=T
YExp=v(4)
XRng=AutoAlways
YRng=10,-2.5
Options=LINEARX,LINEARY
Range Grid Y=2.5
Enable=DontRun
Line Color=#008000
Text Color=#008000
Rainbow=False
VFmtX=3
VFmtY=3
ScaleFactorX="None"
ScaleFactorY="None"
ScaleUnitsX="Auto"
ScaleUnitsY="Auto"
SFmtX=2
SFmtY=2
NOFmtX=3E
NOFmtY=3E

[WaveForm]
Analysis=Transient
Plt=1
AliasID=9
XExp=T
YExp=v(2)
XRng=AutoAlways
YRng=8,-2
Options=LINEARX,LINEARY
Range Grid Y=2
Enable=DontRun
Line Color=#FF00FF
Text Color=#FF00FF
Rainbow=False
VFmtX=3
VFmtY=3
ScaleFactorX="None"
ScaleFactorY="None"
ScaleUnitsX="Auto"
ScaleUnitsY="Auto"
SFmtX=2
SFmtY=2
NOFmtX=3E
NOFmtY=3E

[WaveForm]
Analysis=Transient
Plt=1
AliasID=10
XExp=T
YExp=v(7)
XRng=AutoAlways
YRng=10,-2.5
Options=LINEARX,LINEARY
Range Grid Y=2.5
Enable=DontRun
Line Color=#000000
Text Color=#000000
Rainbow=False
VFmtX=3
VFmtY=3
ScaleFactorX="None"
ScaleFactorY="None"
ScaleUnitsX="Auto"
ScaleUnitsY="Auto"
SFmtX=2
SFmtY=2
NOFmtX=3E
NOFmtY=3E

[WaveForm]
Analysis=Transient
Plt=1
AliasID=11
XExp=T
YExp=i(c1)
XRng=AutoAlways
YRng=16,-4
Options=LINEARX,LINEARY
Range Grid Y=4
Enable=DontRun
Line Color=#0000FF
Text Color=#0000FF
Rainbow=False
VFmtX=3
VFmtY=3
ScaleFactorX="None"
ScaleFactorY="None"
ScaleUnitsX="Auto"
ScaleUnitsY="Auto"
SFmtX=2
SFmtY=2
NOFmtX=3E
NOFmtY=3E

[WaveForm]
Analysis=Transient
Plt=1
AliasID=12
XExp=T
YExp=i(r8)
XRng=AutoAlways
YRng=12,-3
Options=LINEARX,LINEARY
Range Grid Y=3
Enable=DontRun
Line Color=#FF0000
Text Color=#FF0000
Rainbow=False
VFmtX=3
VFmtY=3
ScaleFactorX="None"
ScaleFactorY="None"
ScaleUnitsX="Auto"
ScaleUnitsY="Auto"
SFmtX=2
SFmtY=2
NOFmtX=3E
NOFmtY=3E

[WaveForm]
Analysis=Transient
Plt=1
AliasID=13
XExp=T
YExp=v(8)
XRng=AutoAlways
YRng=12,-3
Options=LINEARX,LINEARY
Range Grid Y=3
Enable=DontRun
Line Color=#008000
Text Color=#008000
Rainbow=False
VFmtX=3
VFmtY=3
ScaleFactorX="None"
ScaleFactorY="None"
ScaleUnitsX="Auto"
ScaleUnitsY="Auto"
SFmtX=2
SFmtY=2
NOFmtX=3E
NOFmtY=3E

[Limits]
Analysis=DynamicAC
FirstValueDisplay=Mag
SecondValueDisplay=PhaseDeg
PlaceText=True

[Limits]
Analysis=DynamicDC
PlaceText=True

[Pane]
Analysis=Transient
CurrentPage 0="MAIN"

[Pane]
Analysis=AC

[Pane]
Analysis=DC

[Pane]
Analysis=HmDistortion

[Pane]
Analysis=ImDistortion

[Pane]
Analysis=Stability

[Watch]
Analysis=Transient
Format=3
ExprPercentWidth=80

[WCTolerance]
Var Width=100
Nominal Width=72
Tol Width=152
Tol Name=Drift
Col Width Neq=50
Col Width Pos=50
Col Width Rnd=50

[WCFiles]
UseFile=<Library>Standard.tlib
AVAILABLE_FILE=<Library>Standard.tlib

[Slider]
Analysis=Transient
Link="V1(pulse.v2)"
Min="5"
Max="40"
Default="20"
Format=3
Method=Linear
Show=True
Font=Height=-15,FStyle=0,Color=#000000,Name=Arial
StepSize=".5"
MRUDockID=59421
Floating=True
LocalOffset=False
Rect=861,223,964,879

[Slider]
Analysis=Transient
Link="R7"
Min="100K"
Max="1000k"
Default="100k"
Format=3
Method=Linear
Show=False
Font=Height=-15,FStyle=0,Color=#000000,Name=Arial
StepSize="100k"
MRUDockID=59421
Floating=True
LocalOffset=False
Rect=827,225,869,264

[Slider]
Analysis=Transient
Link="C1"
Min="20n"
Max="5n"
Default="10n"
Format=3
Method=Linear
Show=False
Font=Height=-15,FStyle=0,Color=#000000,Name=Arial
StepSize="10%"
MRUDockID=59419
Floating=True
LocalOffset=False
Rect=770,231,812,270

[OPMethods]
Analysis=Transient
Standard Newton-Raphson=0,0
Source Stepping=0,0
Diagonal Gmin Stepping=0,0
Junction Gmin Stepping=0,0
Pseudo Transient=0,0

[OPMethods]
Analysis=AC
Standard Newton-Raphson=0,0
Source Stepping=0,0
Diagonal Gmin Stepping=0,0
Junction Gmin Stepping=0,0
Pseudo Transient=0,0

[OPMethods]
Analysis=DC
Standard Newton-Raphson=0,0
Source Stepping=0,0
Diagonal Gmin Stepping=0,0
Junction Gmin Stepping=0,0
Pseudo Transient=0,0

[OPMethods]
Analysis=HmDistortion
Standard Newton-Raphson=0,0
Source Stepping=0,0
Diagonal Gmin Stepping=0,0
Junction Gmin Stepping=0,0
Pseudo Transient=0,0

[OPMethods]
Analysis=ImDistortion
Standard Newton-Raphson=0,0
Source Stepping=0,0
Diagonal Gmin Stepping=0,0
Junction Gmin Stepping=0,0
Pseudo Transient=0,0

[OPMethods]
Analysis=Stability
Standard Newton-Raphson=0,0
Source Stepping=0,0
Diagonal Gmin Stepping=0,0
Junction Gmin Stepping=0,0
Pseudo Transient=0,0

[OPMethods]
Analysis=DynamicAC
Standard Newton-Raphson=0,0
Source Stepping=0,0
Diagonal Gmin Stepping=0,0
Junction Gmin Stepping=0,0
Pseudo Transient=0,0

[OPMethods]
Analysis=DynamicDC
Standard Newton-Raphson=0,0
Source Stepping=0,0
Diagonal Gmin Stepping=0,0
Junction Gmin Stepping=0,0
Pseudo Transient=0,0
