alcor6502/SuperCap-UPS-RasPi-Altium/(list of files, drawings)

Other design files:
Block Diagram.SchDoc
Buck Converter.SchDoc
Cover Page.SchDoc
PANEL.PcbDoc
Revision History.SchDoc
SuperCap UPS Rasp Pi.PrjPcb
SuperCap UPS.SchDoc
