alcor6502/SuperCap-UPS-RasPi-Altium/(commit log)

2022-05-01 Revision A
    Version published on Hackaday.
    Design forked from SuperCap UPS RasPi 485 - Revision D
    [BOM Basic.xls, BOM Complete.xlsx, Block Diagram.SchDoc, Buck Converter.SchDoc, Cover Page.SchDoc, DAC Linerization AVR.xlsx, PANEL.PcbDoc, Parameter Calculator.xlsx]
2022-05-01 Revision B
    [BOM Basic.xls, BOM Complete.xlsx, Buck Converter.SchDoc, Cover Page.SchDoc, Revision History.SchDoc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]
